hijimasa/reduced-dof-humanoid/docs/design_ja.md

# 軸数削減の検討メモ（ROBO-ONE Light 向け）

Copyright 2026 Masaaki Hijikata. Apache-2.0.

## 1. 動機

Pollen Robotics / Hugging Face の Microduck は 15 軸で歩くが、内訳は脚 5×2（股ヨー・股ロール・股ピッチ・膝・足首ピッチ）、首・頭 4、くちばし 1 で、**腕なし・足首ロールなし**である。約 25 cm、800 g 未満、50 Hz のニューラルポリシーで全軸を駆動する。軸数が少ないのは、足首ロールと腕を捨て、横方向のバランスを制御側で吸収した結果といえる。

従来の小型ヒューマノイド（Microban 19 軸、ROBOTIS OP3 20 軸など）の軸数が歩行に対して過剰かどうかを、ROBO-ONE Light の規則とキーフレーム制御の制約のもとで検討した。

## 2. ROBO-ONE Light 規則で軸数に効く条件

2022 年版競技規則（二足歩行ロボット協会）から抜粋。エントリー前に最新版の確認が必要。

- 重量 1 kg 以下（基板・センサ追加で 1.2 kg まで）。
- 足・二つの脚・二つの腕・胴体・頭を有すること。**二つの腕にはそれぞれ一軸以上の稼働軸**。頭は胴体と別パーツで各辺 2 cm 以上だが、可動要件はない。
- レフリー指示で足裏を 10 mm 以上上げて**前後左右に 3 歩以上**移動できること。
- 歩行中は手先を床から 50 mm 以上離す。しゃがみ歩行（膝 90° 以下）は禁止。
- 足裏は脚長の 55 % 以下（最大 10 cm）、左右幅は脚長の 35 % 以下。脚長は最上部のピッチ軸から足裏まで。
- ダウン後は 10 カウント以内に自力で起き上がる。

## 3. 既存機の軸構成

| 機体 | 総アクチュエータ | 脚/片側 | 腕/片側 | 首・腰 | 備考 |
| --- | --- | --- | --- | --- | --- |
| Microban | 19 | 6 | 3 | 首 1 | 全軸シリアル、約 0.82 kg |
| ROBOTIS Mini | 16 | 5 | 3 | 0 | 股ヨーなし |
| ROBOTIS OP3 / Sigmaban | 20 | 6 | 3 | 首 2 | |
| ashigaru | 14 | 4 | 3 | 0 | 足首ピッチはパラレルリンクで受動、約 0.80 kg |
| Microduck | 15 | 5 | 0 | 首 4 + 口 1 | 足首ロールなし、腕なし |

## 4. 軸ごとの判定

| 軸 | 判定 | 根拠 |
| --- | --- | --- |
| 首・頭 | 削る | 規則は頭の存在と寸法のみ要求。Microduck の首 4 軸はカメラ注視と表情用。 |
| 腰ヨー・脊椎 | 削る | 歩行・起き上がりに不要。 |
| 股ヨー | 削る | ROBOTIS Mini と ashigaru が実証済み。旋回は左右非対称ストライドで代替。規則もハの字歩行を許容。欠点は旋回速度。 |
| 足首ピッチ | 受動化 | 大腿・下腿のパラレルリンクで足裏を骨盤と常に平行に保つ。10 mm 段差の上り下りも足裏が水平のまま行ける。失うのは上体だけの前傾と爪先蹴り。 |
| 足首ロール | 残す | 両足接地で骨盤を横移動させるとき、足首ロールが無いと前額面が剛体トラスになり、荷重移動は足裏のエッジ乗りでしか起きない。Microduck は RL と足裏の大きさで吸収しているが、Light の足裏幅は脚長の 35 % までで余裕が小さい。 |
| 股ロール | 残す | 横移動と片脚支持の必須軸。 |
| 股ピッチ・膝 | 残す | 10 mm の足上げ、しゃがみ歩行禁止、起き上がりの全てに必要。 |
| 肩ピッチ | 残す | 規則最低の一軸。パンチ、伏臥からの腕立て、仰臥での振り起き上がりを兼ねる。 |
| 肩ロール | 削る候補 | 側面攻撃と腕開きを失うが、試合本体の規則上は不要。 |
| 肘ピッチ | 用途次第 | 起き上がりで肘を支点にするなら残す。肩 1 軸だけだと伏臥からの押し上げが腕長固定で苦しい。 |

## 5. 構成案

**案 A（推奨、12 軸）**: 脚は股ロール・股ピッチ・膝・足首ロールの 4 軸でピッチ方向パラレルリンク、腕は肩ピッチ + 肘ピッチの 2 軸、首は固定。キーフレーム制御のまま移行できる。肩ピッチだけの 1 軸腕なら 10 軸だが起き上がりが厳しい。

**案 B（8〜10 軸、動的制御前提）**: 脚は股ロール・股ピッチ・膝の 3 軸、足首ピッチはパラレルリンク受動、足首ロールは剛体またはゴムブッシュの受動コンプライアンス。横の荷重移動は支持脚の股ロールで上体を傾けるアヒル歩き。IMU フィードバックが前提で、両足接地時の荷重移動が足裏エッジ乗りになる点と耐押し性がリスク。

## 6. 第一段階: Microban の足首ピッチ受動化と頭の固定

ashigaru と同じ構造を Microban の MJCF に移植し、首サーボを外した。

- 脚ごとに平行四辺形を 2 つ追加。大腿側は股ブロックと膝ブロックを結ぶ後方リンク、下腿側は膝ブロックと足首ブロックを結ぶ後方リンクで、閉ループは equality の connect で閉じる。
- 膝ブロックは受動関節で常に骨盤と平行。膝サーボはこのブロックと下腿の間に入るので、**膝の指令角は骨盤基準**になる。
- 足首ピッチはアクチュエータを外して受動化。
- 頭はモータ無しで胴体に固定する。頭部パーツは残すのでヒューマノイドらしい外形は保たれ、規則上の「胴体から独立した頭」も満たす。19 軸 → 16 軸。
- 後方ピボットは前方ピボットの 20 mm 後方、大腿側は 5 mm 下、下腿側は 5 mm 上。これで特異点が股屈曲 104°・膝屈曲 104° 側に逃げる。可動域は股ピッチ −96°〜+68°、膝 −68°〜+96°（骨盤基準、正は後方振り）。

検証結果（`tools/verify_parallel_leg.py`）:

| テスト | 結果 |
| --- | --- |
| 閉ループ残差（初期姿勢） | 0.000 mm |
| 股・膝 8 姿勢での足裏と胴体の傾き差（無重力） | 最大 0.4° |
| 床上 3 秒、直立 | 胴体傾き 0.08° |
| 床上 3 秒、股 −30°・膝 +30° | 胴体傾き 0.12°、足裏水平 |
| 床上 3 秒、股 −60°・膝 +60° | 胴体傾き 0.33°、足裏水平 |

注意点:

- 相対膝角 120° 以上の深いしゃがみでは足首ブロックが股ブロックに当たる。元の Microban の部品形状由来。
- （この段階では）後方リンクは見た目専用で、実機のリンクと他部品の干渉は未モデル化。第四段階で衝突形状を付けて見直した。
- 既存の Microban モーションは膝が大腿基準なので作り直しが必要。

## 7. 第二段階: 3D モデル最適化（v2）

起き上がりを阻んでいたのは、相対膝角 117° で足首ブロックの U 字ブラケットが股ブロックのブラケットに当たることと、膝の可動域が +96° で止まることだった。実機の部品設計を先取りして、モデルを次のように変えた。

| 変更 | 内容 | 効果 |
| --- | --- | --- |
| 足首ブロック | 足首ピッチ用 XL330 とアイドラホーンを外し、サーボを囲んでいた U 字ブラケットを受動ヒンジ周りの短いクレビス（衝突形状は軸から ±6 mm）にする | 片足 47 g → 25 g。自己干渉限界 117° → 132° |
| 首 | 胴体上部の首サーボを外し、頭を直付け | 胴体 −23 g |
| 後方リンクの傾き | 5 mm → 10 mm（大腿側は下、下腿側は上） | 特異点が屈曲 104° → 116.6° へ。可動域は股 −109°〜+55°、膝 −55°〜+109°（余裕 8°） |

総質量は 0.833 kg → 0.765 kg。検証スクリプトは全項目合格。

## 8. 第三段階: 12 軸版

`--dof 12` で股ヨーと肩ロールを外した。股ヨーサーボは胴体下部に 2 個あるので胴体から外し、股ブラケットを胴体に直付けする。肩ロールサーボは上腕上端にあるので外し、上腕を肩ブラケットに直付けする（腕は体側に垂れた向きで固定）。質量 0.765 kg → 0.673 kg、アクチュエータ 12。脚は股ロール・股ピッチ・膝・足首ロールの 4 軸で、IK は足裏位置 3 + ロール 1 を 4 関節で解く（向きは成り行き）。旋回は ROBOTIS Mini と同じ両足裏の差動押し出し（scuff turn）で行う。

### 12 軸版の動作検証（LegacyMotionEditor の tools/ による）

歩行キーフレームは胴体座標の足裏目標なので、microban 用に調整済みの歩容を 4 軸脚の IK で解き直すだけで移植できた。旋回は ROBOTIS Mini と同じ scuff turn（両足裏の差動押し出し）。起き上がりは物理ビームサーチ（getup_supine.py）で探索し、時間配分を tune_getup.py で詰めた。sim_check.py の外乱付き試行（サーボ零点誤差 0.3°、初期傾き 1°）での結果:

| 動作 | 成功率 | 備考 |
| --- | --- | --- |
| 前進・後退・横移動 | 8/8 | microban の歩容をそのまま移植して約 33 mm/s。tune_gait.py で 12 軸版向けに再調整すると横移動 71 → 59 フレーム、遊脚 45 → 38 フレームに詰まり約 36 mm/s（8/8） |
| 旋回（scuff turn、左右） | 8/8 | 1 周期あたり約 30° |
| ジャブ（左右） | 8/8 | 肩ロール無し、腰ひねり無し |
| うつ伏せからの起き上がり | 15/16 | 7 姿勢 3.9 s。横転して座り、しゃがんで立つ |
| 仰向けからの起き上がり | 16/16 | 寝返り 1 姿勢 + 上記 |

16 軸版（v2）では同じ起き上がりが 9/16 だった。股ヨーと肩ロールのサーボが無くなって 92 g 軽くなったことで、起き上がり中のサーボ飽和が 98% → 60% に下がり、経路の自由度が減ったのに成功率は上がった。

歩行はいずれも静的歩行で、速度は横方向の重心移動時間で決まる。Microban 本家の RL 歩行（前進指令上限 0.7 m/s）や ROBO-ONE 上位機の歩容は動的歩行で、同じ速度域を狙うなら RL か ZMP ベースの歩容生成が必要になる。

歩行中のトルク（前進歩行の再生）: 脚関節の平均 0.11〜0.18 N·m、上限 0.52 N·m への張り付きは 3〜7%。同じ歩容の microban（上限 0.64 N·m）は平均 0.12〜0.21 N·m、張り付き 2〜5%。同じ速度ならトルクは足りている。

## 9. 第四段階: 14 軸版と採用構成（12 軸標準＋14 軸アップグレード）

12 軸版は両足が常に平行で、旋回が床との滑り（scuff turn）に依存する。足首ロールをピッチのようにパラレルリンクで受動化することはできない（膝が曲がると前額面の脚長が変わり、固定長リンクで閉じない）ので、股ヨーを戻して旋回を床に依らず行う 14 軸を採用した。骨盤を割ってヨー 1 軸で結ぶ 13 軸案もあるが、機構が複雑になるので見送り。構成は脚 5×2（股ヨー・股ロール・股ピッチ・膝・足首ロール）、腕 2×2（肩ピッチ・肘）、頭固定、0.725 kg。`--dof 14`。

入門キットとしての標準は **12 軸**（股ヨー無し。Robovie-nano と同じく旋回はすり足）とし、股ヨーの位置には XL330 と同じ外形の 3D プリント製ダミーブロックを入れておく。あとから本物のサーボに差し替えれば 14 軸になり、股ブラケット以下は共通。外したサーボはすべて同形のダミーに置き換えるので、元のブラケットは無改造で使える。

### 費用概算（本家 BOM の価格、XL330 $23.90、サーボ以外 約 $113）

| 構成 | サーボ | サーボ代 | 合計 | Microban（$567）比 |
| --- | --- | --- | --- | --- |
| Microban | 19 | $454 | $567 | — |
| 12 軸標準 | 12 | $287 | 約 $405 | −$162（−29 %） |
| 14 軸（股ヨー追加） | 14 | $335 | 約 $453 | −$114（−20 %） |

追加部品分（M2 ねじ・ワッシャ・フィラメント）約 $5 を含む。設定用 U2D2（$56）は共通で別。国内代理店価格では XL330 が BOM より高めになる。

下腿側リンクのピボットは、足首ロールサーボ（足首軸の後方）と足を避けるため後方 25 mm・上 25 mm に変更した（docs/parts_ja.md）。膝可動域は −37°〜+127°。

### 最終検証（12 軸標準 / 14 軸）

更新後のモデル（ダミーブロック込み、下腿リンク 25/25、第四段階の前方大腿リンクと衝突形状付きの部品）で、
sim_check の外乱付き 8 試行:

| 動作 | 12 軸標準 | 14 軸 |
| --- | --- | --- |
| 前進・後退・横移動 | 8/8（前進 約 32 mm/s） | 8/8（約 32 mm/s、microban の歩容） |
| 旋回 小/大 | 8/8（scuff、約 33°/周期） | 8/8（股ヨー、72° / 141°） |
| ジャブ左右 | 8/8 | 8/8 |
| うつ伏せからの起き上がり | 8/8（6.7 s、9 姿勢。最終形状で再探索） | 8/8（同じ姿勢列を 14 軸で再タイミング、5.2 s） |
| 仰向けからの起き上がり | 8/8（5.1 s、8 姿勢の直接経路。40 試行で 40/40） | 8/8（同じ姿勢列を 14 軸で再タイミング、4.8 s。39/40） |

設計変更のたびに起き上がりが壊れた経緯は第五段階に書いた。最終形状では前腕を 40 mm 延長したことが効き、
うつ伏せ探索 8 シード中 2 つが膝立ちの局所解に落ちずに立ち上がった（再タイミング前 5/8・6/8）。仰向けからの
直接の経路（腕で上体を起こし、股を −100° まで曲げて座る）も見つかり、大腿リンクを後ろに移して広がった
股の屈曲域が効いている。シード 80 の 8 姿勢は探索時の時間配分で 4/8、`tune_getup.py face_up` で 6.2 s → 5.3 s に
詰めると 12 軸で 8/8（40 試行で 40/40）。それまで使っていた「1 姿勢でうつ伏せに寝返ってから同じ経路」は
7/8（40 試行で 37/40）で 8 s かかっていたので差し替えた。

14 軸は 12 軸のタイミングのままだと仰向けが 3/8 だったが、14 軸モデル自身で再タイミングすると
どちらの起き上がりも 8/8 になった（股ヨーサーボ分 30 g の差はタイミングで吸収できる）。ただし仰向けの再タイミングでは
チューナ自身の 40 試行検証（再生速度の揺らぎ込み）を通る候補が出ず、sim_check の 40 試行では 39/40。
12 軸では 24 候補中 15 が通ったので、14 軸の仰向けは余裕が小さい。

再生速度の揺らぎ（±30%）と転送遅延には依然弱いので、Studio で崩れる場合は `build_project.py --compat` の低速版か、`tune_gait --scale-jitter 0.3` / `tune_getup --scale-jitter 0.3` での再調整を使う。

### 肘の可動域

モデルの肘は本家どおり ±125°（正 = 伸展）で、起き上がりは肘を後ろ側に曲げて押す経路を使う。
人間のように前屈曲のみ（−125°〜+10°、`--elbow-flexion-only`）に制限して探索し直すと、
うつ伏せからの起き上がりは最良でも 5/16 にとどまった（制限なしは再タイミング後 15/16）。
前腕は上腕とどちら向きでも干渉しないので、既定は本家の範囲のままにしている。

### LegacyMotionEditor / MuJoCo Studio で詰まった点

- Studio は物理の刻みを 10 ms に固定していた。閉ループ拘束（solref 5 ms）には粗すぎるので、
  モデルの刻み（2 ms）を使い 10 ms を上限とするように変更した。
- 受動関節に `r_knee_yp_1` という名前を付けていたが、これは LME の Meridim 対応表で膝サーボと同じ
  スロットの別名だった。LME が受動関節の角度も送っていたため膝の目標値が 100 Hz で 2 値を行き来し、
  静止中でも脚が痙攣した。受動関節名を対応表に無いもの（`r_kneeblock_yp` など）に変え、LME 側でも
  受動関節を送らないようにした。**受動関節には Meridim 対応表にある名前を付けないこと。**
- 大腿・脛のボディ原点は脚の中心面ではなく内側の側板上にある。横方向の配置は膝サーボの中心を基準にする。

### ROBO-ONE Light 規定の照合

- 脚長（股ピッチ軸〜足裏、脚を伸ばした状態）は 146.2 mm。足裏の上限は前後 80.4 mm、左右 51.2 mm。
- Microban の足裏は 90 × 45 mm で、**前後が 9.6 mm 超過**。接地板を 80 mm にした（`--sole-length 0.080` を既定に）。
  実機の足部品も先端と踵を 5 mm ずつ詰める必要がある。立位での左右の足裏の間隔は 27 mm で重ならない。
- しゃがみ歩行の判定（膝関節 90° 以下）に対し、microban 由来の歩容は立位で膝内角 105.7° だが、遊脚を上げる
  キーフレームでちょうど 90.0°（14 軸の大旋回では 86°）に達していた。足裏 80 mm では旧歩容の前進が 0/8 になる
  こともあり、Z0 ≤ −0.141（立位で膝内角 117° 以上、遊脚で 102° 以上）に探索範囲を絞って歩容を再調整した。

### 第四段階: リンク部品の干渉チェックと配置の見直し

「リンクの部品が干渉しているように見える」との指摘を受け、追加部品に凸包の衝突形状を持たせて
股・膝の可動域全体を走査した（`tools/check_clearance.py`）。見た目専用だった旧配置（大腿バーを
大腿の後ろに内外 2 本）には本物の干渉があった。

| 干渉 | 対処 |
| --- | --- |
| 左右脚の内側の大腿バー同士が 8 mm しか離れておらず、股ロールで当たる | 内側バーを廃止、脚ごとに外側 1 本ずつ |
| 大腿バーと下腿バーが同じ面にあり、股屈曲 60° 以上で交差 | 大腿リンクを大腿の**前方**（当初 前 22 mm・上 10 mm、第五段階で前 27・上 12）に移し、バーの面を分離（最終的に 22.5〜25.5 / 26〜29 mm） |
| 後方の大腿バーが垂らした前腕に当たる | 前方化で解消 |
| 前方の大腿バーが股屈曲 90° 以上で膝軸キャップのスタブに当たる | 股屈曲の可動域を 85° で打ち切り（起き上がりで使うのは 37° まで）。ピボットを 16 mm 上げる案は伸展側の特異点が 54° になり、起き上がりの股伸展 55° が入らないので不採用 |
| 歩行で股を 45° 曲げると膝ヨーク板の上端が前腕に 2 mm 食い込む（サーボ飽和率 19 % → 72 %） | ヨーク板の縁を 7 → 5 mm に詰める |
| 肘を前に曲げると前腕が大腿バーとヨーク前端に当たる（前 40° で 3.5 mm、前 60° で 0.6 mm。後ろ曲げなら当たらない） | 肩ロールのダミーブロックのホーンを 30° 割り出し、腕を 30° 外転（`--arm-abduct 30`）。歩行の姿勢範囲で肘 0〜−90° のどれでも干渉なし。歩容の基本姿勢は人間のように肘前 60° |
| キャップ（フランジ＋スタブ）の凸包が円錐になり偽の干渉を報告 | キャップの衝突形状だけ円柱 2 本に分割 |

結果、可動域内の干渉はゼロ。可動域は股ピッチ −85°〜+58°、膝 −37°〜+127°。歩容はすべて 8/8 のまま。
一方、うつ伏せでは大腿の前に出たバーとヨークが床に先に着くため、以前の起き上がり経路は通らなくなり、
衝突形状付きのモデルで起き上がりを探索し直した（結果は上の最終検証の表）。

腕を 30° 外転させると、部品の衝突形状付きで見つけた 5 姿勢の起き上がりも通らなくなった（腕の形が変わると
押す位置が変わる）。探索し直すと 16 シード中 15 が「膝立ちで止まる」局所解（胴体ピッチ 20°、重心高 89 mm）に
落ちた。パラレルリンク脚は骨盤を立てたまま膝立ちすると足裏が垂直になるので、そこから立つ経路は骨盤を大きく
前傾させるものしかなく、股屈曲の上限 85° が原因かと疑って上限 100° の試験モデルでも探索したが、見つかった
経路（s32）は股屈曲 −20°〜伸展 58° しか使っておらず、上限 85° のモデルでもそのまま同じ結果（再タイミング前
4/8）だった。つまり上限は原因ではなく、探索のばらつき。見つかった経路は寝返って反対向きに立つ 6 姿勢。

教訓: **リンク機構は見た目だけでなく衝突形状を付けて可動域を走査してから設計を固めること。** 凸包の
衝突形状は段付きの部品で偽陽性を出すので、形状を分けるか原始形状で置き換える。

### 第五段階: ダミーサーボの一体設計化

足首ピッチ・肩ロール・首の XL330 形状ダミーを、隣の印刷部品と一体の部品に置き換えた（`tools/make_parts.py` が
Microban の STEP から生成、`model/parts_derived/`）。

| 部位 | 置き換え | 要点 |
| --- | --- | --- |
| 足首 | ankle_dbl_block ＋ ダミー → ankle_block_integrated | キャップにヒンジ体を融合。Ø5.9 スタブ軸が脛側板の既存穴に入り、下腿バーのピボットボスも一体（スタンドオフ不要） |
| 肩ロール | shoulder（U 字ブラケット）＋ humerus ＋ ダミー → shoulder_arm_simple | ホーン板・梁・柱・肘板だけの単純な 1 部品（穴位置と肘サーボの角ポケットだけ継承）。腕は元のロール軸まわりに ±30° 回した形で固める。肩ピッチホーンのねじにはドライバを通す Ø5 の段付き穴 |
| 首 | head ＋ ダミー → head_integrated | 頭の裏の旧ホーン座を埋め、旧サーボ軸上の素直なステムで台座につないだ 1 部品。逆さ付けの首サーボのポケットに入り、胴体の内側から M2 4 本で固定。頭の高さは変えない |

股ヨーのダミーだけは 14 軸への差し替えのために XL330 形状のまま（2 mm シェルに変更）。質量は印刷部品を
1.0 g/cm³ で計上して 12 軸 0.735 → 0.726 kg、14 軸 0.765 → 0.756 kg（公開前の最終確認で肩＋上腕の体積が
旧形状の 9.5 cm³ のままだったのを CAD 値 13.5 cm³ に直し、12 軸 0.734 kg・14 軸 0.764 kg）。
あわせて、大腿バーの上側ピボットを受ける股の耳（hip_front_ear）が生成はされていたのにモデルに置かれておらず、
LME の表示でバーの上端が浮いて見えていた。置いてみると大腿側板と丸ごと干渉していたので（側壁に貼る板が側板の
位置そのものだった）、別部品をやめて股ブラケットから生やす支持にした。大腿側板は股軸の前方を扇状に掃き、
前縁は軸から 40 mm 以上離れているので、軸の前では側板の面（|x| 14.5〜18.5）を横切れない。支持は軸の後ろ下で
ブラケットを出て側板をくぐり、側板の外を前へ回ってピボットに至る。ピボットは軸から 29.5 mm（前 27・上 12）に
移し、バーの面を 1.5 mm 外へずらした。CAD で大腿（股ピッチ全域）と骨盤側ブラケット（ロール ±35°）に対して
交差ゼロを確認。さらに「もっとリンクの支持点の近くから」との指摘で、腕を外転させた今は前腕を避ける理由が
無いことから大腿リンクを後ろ（後方 22・下 8）に戻した。股側ピボットは股ブラケットの後ろ裾のすぐ横に来るので
支持は 23 mm のラグで済み、可動域も股 −100°〜+62° に広がった。両バーが後ろにあるため大腿バーはヨークの外側
（35〜38 mm）に出す（内側だとヨークの下腿ピンが掃き、股伸展 57° 以上で膝軸スタブに触れる）。膝のピン穴を
共通化する案は、股の伸展範囲と膝の屈曲範囲の要求が逆向きで採れなかった。
肩の一体部品も、細い板と梁の組合せは印刷に向かず鋭角も多いという指摘で、壁 3 mm の太い胴と柱に作り直した。
腕は KXR や Robovie-nano より短く見えるとの指摘で、前腕を 40 mm 延長した（肩軸から 183 mm。規定は 26 cm まで、
歩行中の手先高さ 50 mm 以上に対して腕を伸ばした屈み姿勢でも 86 mm）。肘サーボの保持も最初は端面にねじ穴がある前提で間違えていたので、Microban の上腕プレートと同じく
ホーン側・アイドラ側の面の上隅穴にホーン軸方向のねじで留める 2 枚のタブに直した（穴軸と面位置をモデル上で照合）。`--dummies` で旧構成を生成できる。
Robovie-nano のようなすね 1 段のリンクは、足裏が大腿と平行になり歩幅を持つ両脚支持で足裏を平らにできないので
採用しない（足裏を骨盤と平行に保つには関節ごとに 1 段、計 2 段が要る）。

## 10. 次の段階

1. ドラフト部品を Onshape で元部品と組み合わせてフィット確認し、印刷する（未確認事項は parts_ja.md）。
2. 脚長が確定したら足裏寸法を ROBO-ONE Light の表（55 % / 35 %）と照合する。
3. 動的歩行を試すなら、本家の学習パイプライン mjlab_microban にこのモデルを差し替える。

## 参考

- Pollen Robotics, Microduck press kit: https://pollen-robotics.com/microduck/press-kit/
- CNX Software, Microduck 記事 (2026-08-28): https://www.cnx-software.com/2026/08/28/microduck-a-duck-like-biped-robot-designed-for-physical-ai-experimentation-and-fun/
- OpenELAB, MicroDuck build guide（関節 ID 表）: https://openelab.io/fi/blogs/robotics/microduck-build-guide-openelab
- 二足歩行ロボット協会, ROBO-ONE/Light/auto 競技規則 (2022): https://www.robo-one.com/upload/roboones/65_63bfd2f1042650ddc6d9e47ad179db2eoriginal.pdf
- Rhoban, Microban: https://github.com/Rhoban/microban
