hijimasa/reduced-dof-humanoid/docs/images/preview.png

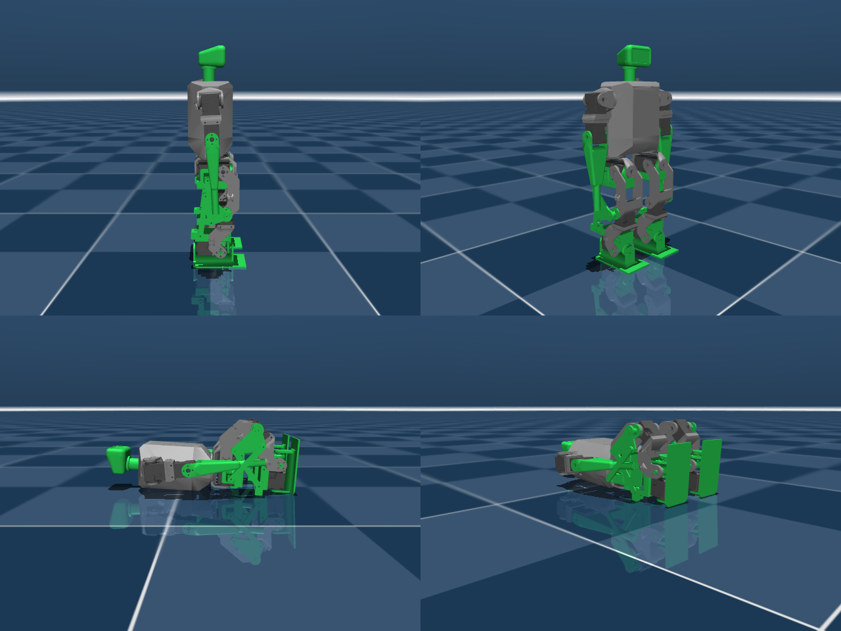
docs/images/preview.png
