hijimasa/reduced-dof-humanoid/docs/parts_ja.md

# パラレルリンク化で追加・変更する部品（設計メモ）

Copyright 2026 Masaaki Hijikata. Apache-2.0.

`tools/make_parts.py`（CadQuery）が `model/parts/` に出力する STL は**フィット確認前のドラフト**です。
寸法は MJCF の関節配置と、Microban の STEP ファイルから読み取った穴パターンに基づきますが、
まだ一度も印刷していません。Onshape で元部品と組み合わせて確認してから使ってください。

モデル上ではこれらの部品（緑）に凸包の衝突形状を持たせてあり、`tools/check_clearance.py` が
股ピッチ・膝の可動域全体を走査して他部品との干渉を報告します。現在の配置では可動域内に干渉はありません
（腕を真下に垂らしたまましゃがむと前腕が下腿バーに 0.5 mm 触れる姿勢だけが残っています。どのモーションも
そこへは行きません）。

## 座標系

Microban の Onshape 部品（femur_right.step、tibia_right.step、ankle_dbl_block.step）は同じ
「脚座標系」で出力されています。右脚で x = 外側、y = 前、z = 上、単位 mm。
股ピッチ軸 (y 3.0, z 132.7)、膝軸 (8.0, 70.7)、足首軸 (0.0, 9.5) は STEP の穴中心と一致します。
側板は |x| 14.5〜18.5、サーボ本体は |x| ≤ 10、股・足首ブラケットの側壁は |x| 11.5〜13.5。

注意: MJCF の大腿・脛ボディの原点は脚の中心面ではなく**内側の側板上**（中心から 14.5 mm 内側）にあります。
横方向の配置はすべて膝サーボの中心（ホーン面とアイドラ面の中点）を脚の中心面として測ります。
生成器はこれを `c_z`（ボディ座標）と `x_c`（STEP 座標）として計算しています。
また、クレビスはサーボに対して非対称で、ホーン側は側板内面までサーボ面から 4.5 mm（ホーン 3 + 1.5）、
アイドラ側は側板がサーボ面に接しています。足首ヒンジ用ダミーのスペーサ長はそれに合わせています。

## ピボット配置（`make_microban_pl.py` の既定値）

| リンク | 上側ピボット | 下側ピボット | リンク長 | 特異点 |
| --- | --- | --- | --- | --- |
| 大腿（**後方** 22、下 8） | 股ブラケットのラグ (y −19.0, z 124.7) | 膝ヨーク (−14.0, 62.7) | 62.2 | 屈曲 110.6°、伸展 69.4° |
| 下腿（後方 30、上 30） | 膝ヨーク (−22.0, 100.7) | 足首ブロックのボス (−30.0, 39.5) | 61.7 | 屈曲 135°、伸展 45° |

可動域は特異点から 8° の余裕をとり、股ピッチ −100°〜+62°、膝 −37°〜+127°（骨盤基準、正は後方振り）。
起き上がりで使うのは股 −37°〜+55°、歩行は −45°〜0° です。

## 横方向の積層（脚の中心面からの距離、右脚）

| 面 | x [mm] | 部品 |
| --- | --- | --- |
| 大腿・脛の側板 | 14.5〜18.5 | 元部品 |
| 膝軸キャップのフランジ | 18.5〜20.5 | knee_axle_cap（膝サーボのホーンねじで共締め） |
| 下腿バー | 26〜29 | shank_bar（ヨークに隣接、スペーサ無し） |
| 膝ヨーク板 | 29.5〜32.5 | knee_yoke（キャップの Ø8 スタブに乗る。スタブは 33 まで、皿 M2 で抜け止め） |
| 大腿バー | 35〜38 | thigh_bar（ヨークの外側。ヨークから Ø6 スペーサ 2 mm で受ける） |
| 股ブラケットのラグ | 11〜34.5 | hip_block_integrated（10×10 の角柱、先端に Ø2.2 のピン穴） |

3 本の面は 0.5 mm ずつ離してあり、バー同士は面が違うので股を深く曲げてもすれ違えます。
垂らした前腕は x 22〜32.5、z 112 以上を占めるので、この積層は丸ごと前腕の下に入ります。

## 配置の経緯（干渉チェックで直した点）

最初の案は大腿リンクを大腿の後方に置き、各脚に内側・外側 2 本のバーを通していました。衝突形状を付けて
調べると次の干渉があり、現在の配置に改めました。

- 左右脚の内側バー同士の間隔が 8 mm しかなく、股ロールで脚を寄せると当たる。→ 内側バーを廃止し、
  バーは外側 1 本ずつに。
- 後方の大腿バーと下腿バーが同じ面にあり、股屈曲 60° 以上で交差する。→ 大腿リンクを大腿の**前方**に
  移し、バーの面も分けた。
- 後方の大腿バーが垂らした前腕に当たる。→ 前方化で解消。
- 大腿バーを前方にすると、股屈曲 90° 以上で大腿バーが膝軸の上を通り、膝軸キャップの Ø8 スタブに
  当たる（ピボットを 16 mm 上げれば 100° まで逃げるが、伸展側の特異点が 54° に下がり、起き上がりで
  使う股伸展 55° が入らなくなる）。→ ピボットは上 10 mm のまま、股の屈曲側の可動域を 85° で打ち切った
  （85° で余裕 2 mm）。
- 歩行で股を 45° 曲げたとき、膝ヨーク板の上端が垂らした前腕に 2 mm 食い込む。→ ヨーク板の縁の
  オフセットを 7 → 5 mm にして上端を下げた。
- 垂らした前腕（脚中心から 22〜32 mm）はリンク積層（21〜31 mm）の真上にあり、肘を前に曲げると前腕が
  大腿バーとヨーク前端に当たる（前 40° で 3.5 mm、前 60° で 0.6 mm）。後ろ曲げなら当たらないが
  人間らしくない。→ 肩ロールのダミーブロックのホーンを 30° 割り出して腕を外転させた。肘は 24 mm
  外に出て、歩行の姿勢範囲（股 0〜−55°、膝 20〜70°、肩 −15〜40°、股ロール ±10°）で肘 0〜−90° の
  どれでも前腕は部品に触れない。歩容の基本姿勢は肘前 60°。
- MuJoCo はメッシュを凸包で扱うので、フランジ＋スタブのキャップを 1 つのメッシュにすると円錐状の
  偽の干渉が出る。キャップの衝突形状だけは円柱 2 本にしてある。

## 配置の制約（部品の占有範囲を脚座標系に写して確認）

- 股ロールサーボ（x ±10、y −35.5〜−9.5、z 108〜142）が股ピッチ軸の後方にある。大腿側板（|x| 14.5〜18.5）は
  股軸の前方を扇状に掃く（前縁は軸から 40 mm 以上）ので、軸の前では x 14.5〜18.5 を横切れない。前のバーの
  ときは支持が軸の後ろ下から側板をくぐり外側を前へ回る長い迂回になった。大腿リンクを後ろ（後方 22・下 8）に
  すると、股側ピボット (−19, 124.7) は股ブラケットの後ろ裾（x 11.5〜13.5、y −30〜−6、z 117〜125）のすぐ横、
  大腿が伸展の限界でもかすめない象限に来るので、裾から x 34.5 まで伸びる 10×10 のラグだけで持てる。
  CAD で大腿（股ピッチ −62°〜+100°）と骨盤側ブラケット（ロール ±35°）に対して交差体積ゼロを確認。
- 両バーを後ろに置くと、ヨーク上の 2 つのピンが互いのバーの掃引域に入りやすい。大腿バーをヨークの内側に
  置くと、ヨークの下腿ピン用スペーサが大腿バーの面を横切り、膝屈曲でそこを下腿バーが掃く。さらに後ろ・下の
  大腿バーは股伸展 57° 以上で膝軸の Ø8 スタブに触れる。そこで大腿バーをヨークの外側（35〜38）に出した。
  スタブは 33 までで皿 M2 で抜け止めし、バーとの隙間は 2 mm。膝のピン穴を共通化する案（大腿・下腿の
  オフセットを同じにする）は、股の伸展範囲（下オフセットを小さく）と膝の屈曲範囲（上オフセットを大きく）の
  要求が逆向きで、どちらかを起き上がりの必要量より削ることになるので採らなかった。
- 足首ロールサーボ（x ±10、y −38.5〜−12.5、z 0〜34）が足首軸の後方にある。下腿リンクの下側ピボットを
  後方 20・上 10 にすると中に入るので、後方 25・上 25 に上げた。
- 脛（側板は y −18 まで）: 下腿リンクは z < 51 で y < −18 に収まる必要があり、後方 25 で満たす。
- 足（x ±22.5、z ≤ 18.5）: 下腿リンク下端（z 34.5）は足の上面より上。
- うつ伏せに寝ると、大腿の前面より 12 mm ほど出ている大腿バーとヨークが床に先に着く。起き上がりの
  探索はこの状態から行っている。実機では M2 ピンと 3 mm 厚 PLA のバーに体重の一部が掛かるので、
  印刷後に確認すること。

## 部品一覧

| 部品 | 数 | 内容 | 取り付け |
| --- | --- | --- | --- |
| thigh_bar | 2 | 3×8 mm、ピン間 62.2 mm、Ø2.2 | 脚ごとに後方・ヨークの外側 1 本、x = 35〜38 |
| shank_bar | 2 | 3×8 mm、ピン間 61.7 mm | 脚ごとに後方・ヨークの内側 1 本、x = 26〜29 |
| knee_yoke_right / left | 各 1 | 膝軸・大腿ピボット・下腿ピボットの三角板（縁 5 mm、膝軸まわり Ø16）。膝軸は Ø8.2 の穴、各ピボットは M2 ピンとバーまでの Ø6 スペーサ一体 | x = 29.5〜32.5、膝軸キャップのスタブに乗せ M2 で抜け止め |
| knee_axle_cap | 2 | Ø18×2 のフランジ（PCD 12 の M2×4 で膝サーボのホーンに共締め、大腿側板を貫通するので M2×12 に延長）＋ Ø8×12.5 のスタブ（x 33 まで、ヨーク板から 0.5 mm 出る）、先端に皿 M2 用タップ | 大腿側板外面（x 18.5）から外へ |
| standoff_shank_ankle | 2 | 12.5 mm スペーサ（`--dummies` 版のみ） | 足首ブラケット側壁（13.5）→ 下腿バー（26）。一体化版では足首ブロックの支持に置き換わる |
| ankle_block_integrated_right / left（parts_derived） | 各 1 | Microban の足首ブロック（2 つのサーボの上に被さるキャップ）に、足首ピッチサーボの代わりのヒンジ体を融合した 1 部品。ピッチ軸上に Ø12 ボス（x −11.5〜14）、両端に Ø5.9 スタブ（ホーン側は Ø12 カラー 2.7 mm 付きで x −20 まで、アイドラ側は x 20 まで）、先端に M2 タップ。ボスから上は 1.6 mm 壁の中空柱でキャップに連結。下腿バーのピボット支持も一体: キャップ後端の角に根元ブロック（x 11〜14、y −38.5〜−30、z 31〜44、側板の内側）、そこから出る 8×8 の梁（y −44〜−38、z 36〜44。足首軸から r ≥ 46 mm で、脛側板が膝伸展で掃く帯 r ≤ 45・113〜150° の外）、側板の外（x 21〜25.5）で前へ戻る腕（y −44〜−25、z 33〜44）にピン穴 (−30, 39.5)。以前の Ø6 片持ちボスは廃止。CAD で脛（膝 −37°〜+127°）・足（ロール ±35°）と交差ゼロ | キャップの元の位置。ロールサーボには元どおりねじ止め |
| shoulder_arm_simple_right / left | 各 1 | 肩ブラケット＋上腕の太い一体部品（Microban の形状は使わず、インターフェースだけ継承）。上腕座標で: 肩ピッチホーンの板 x −52.2〜−48.2（4 mm、y ±11、z 12〜37、面取り）に PCD 12 の M2 穴 4 本（(y ±6, z 24.5)・(0, 18.5)・(0, 30.5)）と Ø7.5 の中心穴。肘サーボは Microban の上腕プレートと同じ持ち方: XL330 の端面にねじ穴は無いので、天板（z −2.5〜1.5、x −47.5〜−17.5、y ±11.5、面取り）から下がる 2 枚の短いタブ（x −46.6〜−44.2 と −20.6〜−18.2、z −8〜−2.5）に、ホーン軸方向（x）の Ø2.2 穴を (y ±8, z −4.5) に開け、サーボのホーン側の面とアイドラ側の面の上隅の穴に M2 を通す（穴面は Microban と同じ x −45.4 / −20.0）。左腕の部品は右腕の部品をロール軸の面（上腕座標 x = −32.7）で鏡像にしたもの。Microban の左腕は右腕をこの面で鏡像にした配置（肩ピッチホーンが x −13.2、肘サーボのホーンが反対端）なので、これで肩ピッチ板・肘タブとも左右で正しい側に来る（モデル上で数値確認済み）。16×16 の中空柱（壁 3 mm）を肘板から立て、肘板＋柱を元のロール軸 (x −32.7, z 24.5) まわりに右 −30°・左 +30° 回してから、24×18×21 の胴（壁 3 mm、x −48.2〜−24）でホーン板につなぐ。ホーンのねじは外側から締めるので、胴と柱を貫く Ø5 の段付き穴を通してドライバを入れる。オーバーハング無し。モデル上でタブの穴軸がホーン軸と平行で、タブ面がサーボのホーン面の 1.2 mm 外にあることを数値で確認済み | 肩ピッチサーボのホーンに M2 4 本。肘サーボはホーン側・アイドラ側の面に 2 本ずつ |
| head_integrated（parts_derived） | 1 | Microban の頭（head.step）に首を生やした 1 部品。頭の裏の旧ホーン座（PCD 12 の穴、座ぐり）は Ø24 のパッドで埋め、旧サーボ軸上の Ø18/Ø12 中空ステムが、胴体上面のポケット（20×34、深さ 7.5）に入る中空の台座（床 2 mm、壁 1.6 mm）まで下りる。底面にホーンの PCD 12 に合わせた M2 タップ 4 本 | 胴体上部のポケット。Microban は首サーボを逆さに付けており（ホーンが胴体側、頭がサーボ本体側）、胴体の内側からポケットの床越しに 4 本の M2 で固定する（胴体上カバーを外して作業） |
| hip_block_integrated_right / left（parts_derived） | 各 1 | Microban の股ブラケット（hip_dbl_block）に大腿バーの上側ピボットのラグを生やした 1 部品。裾の外面に 22×24 のフランジ（x 11〜14、角 R3）を当てて薄い壁に荷重を広げ、そこから 20×22 → 12×12（2 mm で絞る）→ 10×10（x 34.5）とテーパーするラグ、付け根は R2.5 のフィレット（直角の根元にしない）。先端に Ø2.2 のピン穴 (−19.0, 124.7) | 元の股ブラケットの位置。ねじは増えない |
| radius_long（parts_derived） | 2 | Microban の前腕（radius.step）の手先に、前腕軸に沿って Ø10・長さ 40 mm の棒（先端 R5）を生やしたもの。腕は肩軸から 183 mm。モデルでは衝突形状として同じ位置にカプセルを置く | 元の前腕の位置 |
| xl330_dummy_hip_yaw | 2 | XL330 の外形（20×34×26、2 mm シェル）と背面 4 穴、固定ホーン付き。12 軸標準構成で股ヨーサーボの位置に入れ、14 軸化のときに本物と差し替える | 胴体下部、股ブラケットの上 |
| xl330_dummy_shoulder_roll_right / left、xl330_dummy_neck、xl330_dummy_ankle_hinge | 代替 | 一体化部品を使わない場合（`--dummies`）の XL330 形状ダミー。肩ロール用はホーン穴を ±30° 割り出し、足首用は両面に Ø5.9 スタブ軸 | それぞれのサーボの位置 |

既存部品の変更:

- hip_dbl_block: 一体化部品 hip_block_integrated に置き換える（元の形状を含む）。
- ankle_dbl_block: 一体化部品 ankle_block_integrated に置き換える（元のキャップ形状を含む）。`--dummies` 版では元のまま使い、xl330_dummy_ankle_hinge を入れて側壁 (y −25.0, z 34.5) に M2 穴を追加。
- shoulder（U 字ブラケット）と humerus: 新設計の shoulder_arm_simple に置き換える（元形状は使わない）。
- head: 一体化部品 head_integrated に置き換える（元の頭の形状を含む）。trunk_top は変更なしで、首サーボのポケットと穴をそのまま使う。
- 足首ピッチの受動ヒンジは、脛側板の既存の Ø6 穴（ホーン側・アイドラ側）をそのまま軸受けに使う想定。
- 足: 接地板を先端側で 10 mm 詰めて 80 mm にする（ROBO-ONE Light の 55 % 規定、`model/parts_derived/foot_sole80`）。

## ダミーの一体化（足首・肩・首）

XL330 形状のダミーは「元の部品を無改変で使う」ための暫定品で、隣の印刷部品と 1 つにできる。
インターフェースの寸法は Microban の robot.xml（サーボの位置と向き）と STEP ファイルから読み取った。

- 足首: 足首ピッチサーボは x −11.5〜14.5、y ±10、z 0〜34 に立っていて、ホーンが x −11.5 側（ホーン円板 −11.5〜−14.5 が
  脛側板の内面 14.5 に接する）、アイドルキャップが x 14.5 側。キャップ（ankle_dbl_block）は両サーボの上面に乗る。
  サーボを抜いた穴にヒンジ体（Ø12 ボス＋中空柱）を融合し、キャップは元の形のまま残すのでロールサーボ側の
  取り付けは変わらない。ブロックは左右で同じ向きに付いているので、ホーン側（−x）は右脚では内側、左脚では外側になる。
  外側に出す下腿バーのピボットボスだけ左右で側を変える（右 +x、左 −x）。
- 肩: 肩ロールサーボは上腕プレートの上に立ち、ホーン軸は前後方向（+y）。元のブラケットは上腕座標で x −52.2〜−23.7 を
  占め、基板（x −52.2〜−48.4）が肩ピッチホーンに付く（PCD 12、robot.xml と shoulder.step から）。最初は元の U 字
  ブラケットと上腕プレートをそのまま融合したが、印刷するには複雑すぎるので、ホーン板・梁・柱・肘板だけの単純な
  形に設計し直した（ホーンの穴位置と肘サーボの穴位置・角ポケットだけを継承）。ホーンのねじは板の外側から締める
  ので、梁と柱を貫く Ø5 の穴をねじ軸に沿って開け、ドライバを通す。
- 首: Microban は首サーボを逆さに付けていて、ホーン（z 148.4、PCD 12）が胴体上面のポケットの床に、頭（z 174.4）が
  サーボ本体の上端に付く。頭の STEP 座標は胴体上面の STEP 座標と同じ。頭の裏の旧ホーン座は埋めて、旧サーボ軸
  (36, 7.79) 上の素直なステムで台座につないだ。固定は胴体の内側からポケットの床越しに M2 4 本。
- 質量（1.0 g/cm³ 換算、make_parts.py が出力する CAD 体積）: 足首ブロック 9.2 → 17.3 cm³、股ブラケット 9.7 → 13.3 cm³、
  肩ブラケット 8.8 ＋ 上腕 4.3 → 肩＋上腕 13.5 cm³、頭に生やした首 6.4 cm³、前腕の延長 +2.8 cm³（モデルでは 4 g で計上）。
  XL330 形状ダミーは 2 mm シェルで 7.7 cm³。モデルの総質量は 12 軸 0.734 kg、14 軸 0.764 kg、16 軸 0.809 kg。
- 一体化部品には衝突形状を付けていない（元の部品にも無い）。足首の衝突は従来どおり短いクレビスの箱で表す。

## 未確認事項

- XL330 背面穴パターン（16 × 25.5 mm）は STEP の穴座標からの推定。実物で確認すること。胴体上面のポケットには
  (28, −14.7)・(44, 15.3) の対角 2 穴（Ø2.5）があり 16 × 30 のパターンに見える。head_integrated の台座の底はホーンの PCD 12 だけに
  合わせてある。
- 一体化部品は印刷していない。ヒンジ体（1.6 mm 壁の中空柱）と上腕の柱の剛性、ankle のキャップ部の元形状との
  融合面（z 31〜34）が意図どおり繋がっているかを CAD で確認すること。肩の Ø5 アクセス穴は M2 のドライバ軸
  （Ø3〜4）を想定しているので、使うドライバに合わせて径を直すこと。
- 首ポスト付きの頭は胴体の内側から固定するため、胴体上カバー（trunk_top）を外した状態で組む手順になる。
- 足首側のピボット支持は、脛側板の掃引帯を避けるために軸から遠回りする 8×8 の梁（長さ 15 mm）と腕（12 mm）。
  下腿バーの引張り上限は膝サーボのストールトルク / てこ 42 mm ≈ 12 N で、梁の曲げは 0.2 N·m 程度（PLA で 4 MPa）。
  キャップ（2.5 mm 厚）側の根元は 8.5×13 mm の面で融合するが、キャップ自体が薄いので当て板を検討。
- 膝ヨークが片持ちで足りる剛性か（PLA、荷重はリンク反力のみ）。Ø8 の PLA スタブで不足なら、
  キャップ中心に M3 を通してボルトを軸にする。
- 股ブラケットのラグは 23 mm の片持ち。大腿バーの力はバーの軸方向（ほぼ鉛直）で、膝サーボのストールトルク
  0.52 N·m をてこ 23.4 mm で割った約 22 N が上限。根元の曲げは約 0.5 N·m で、20×22 の根元断面なら 1 MPa 以下
  （PLA）。根元はフランジとフィレットで直角を避けたが、積層方向（裾の面に平行に印刷すると層間がラグの曲げを
  受ける）には注意。横向き（ラグを寝かせて）印刷するか、裾の内側に当て板を入れることを印刷時に検討。
- うつ伏せ時に大腿バーとヨークが床に着くこと（上記）。
- 肘を前に 60° 曲げた歩行の基本姿勢で手先は床から約 110 mm（規定 50 mm 以上）。実機の腕と脚の
  間隔は前腕の径（Ø10.4 でモデル化）と外転角に依存する。外転 30° は余裕が大きい（前腕内側とヨーク
  外面で約 35 mm）ので、見た目を優先するなら 15〜20° まで減らせる。
