hijimasa/reduced-dof-humanoid/model/microban_pl/assets/radius.stl

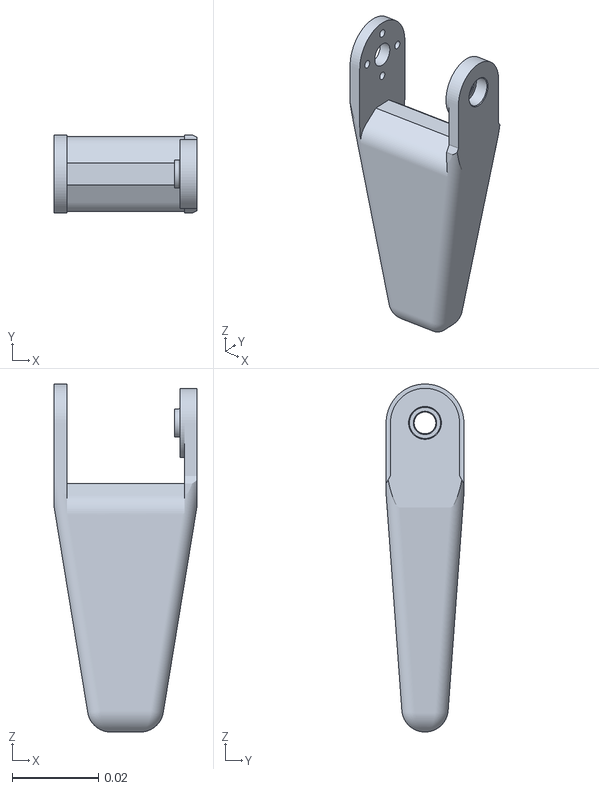
[picture p6: CAD file, 2026-10-16]
model/microban_pl/assets/radius.stl
0.033 x 0.018 x 0.0805
