hijimasa/reduced-dof-humanoid/model/parts/shoulder_arm_simple_left.step

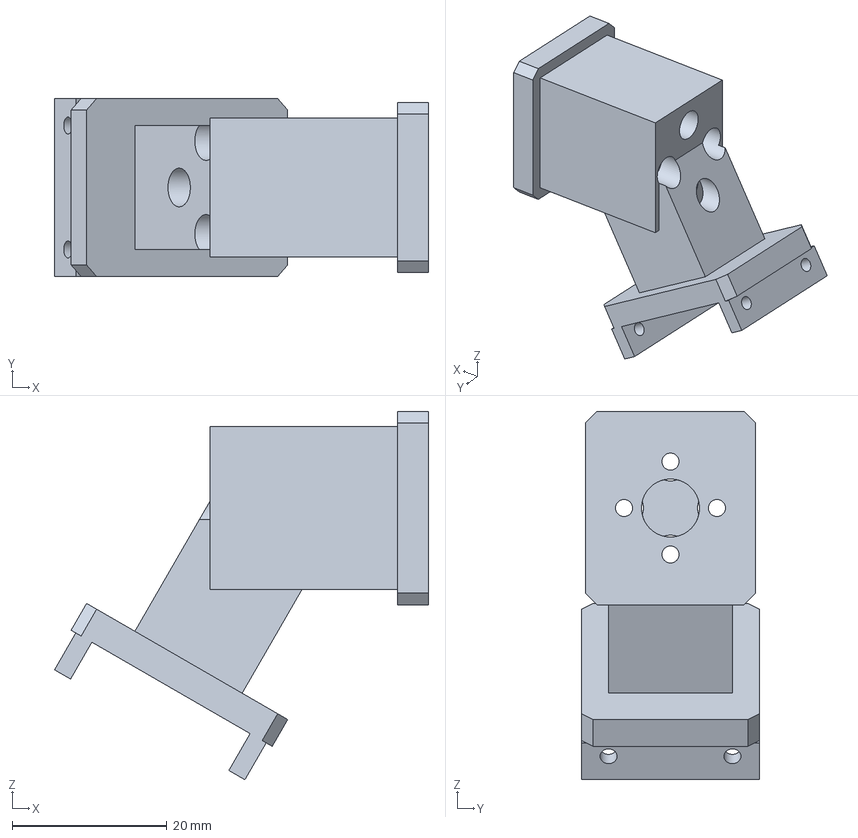
[picture p7: CAD file, 2026-10-17]
model/parts/shoulder_arm_simple_left.step
48.3 x 23.0 x 47.6 mm
