hijimasa/reduced-dof-humanoid/model/parts_derived/ankle_block_integrated_right.step

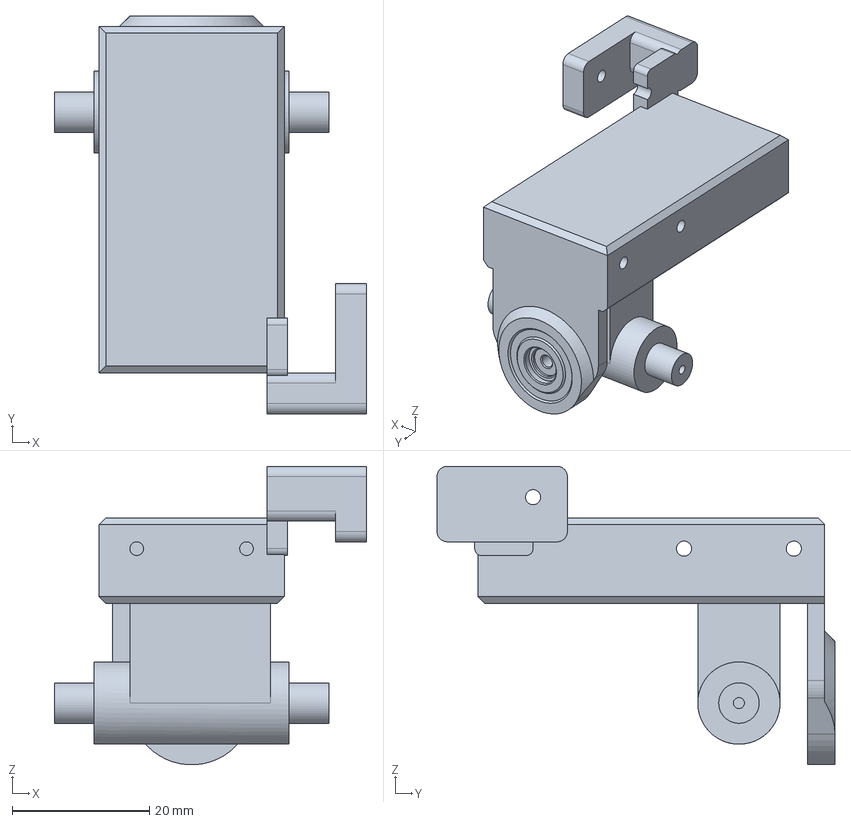
[picture p8: CAD file, 2026-10-17]
model/parts_derived/ankle_block_integrated_right.step
45.5 x 58.0 x 43.5 mm
