hijimasa/reduced-dof-humanoid/model/microban_pl/assets/switch.stl

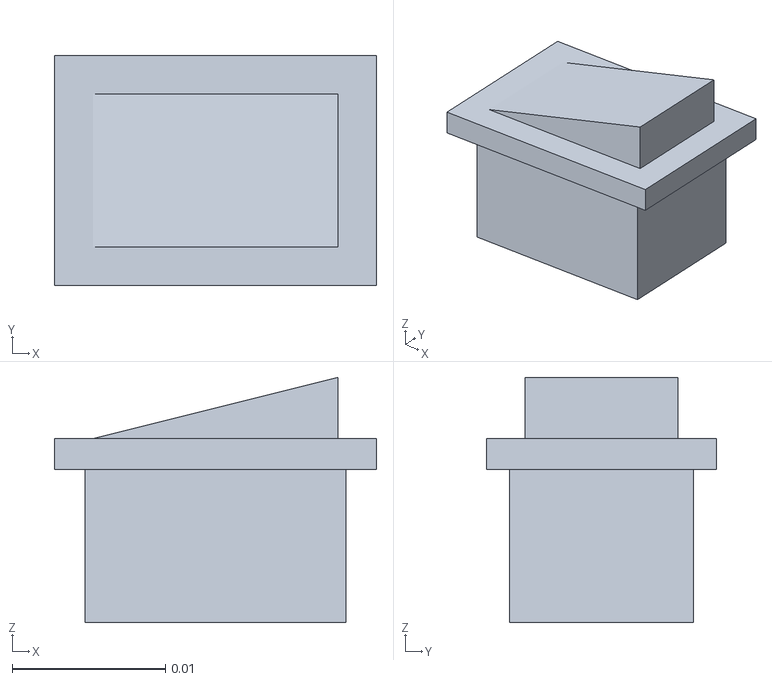
[picture p9: CAD file, 2026-10-16]
model/microban_pl/assets/switch.stl
0.021 x 0.015 x 0.016
