hijimasa/reduced-dof-humanoid/model/parts_derived/radius_long.step

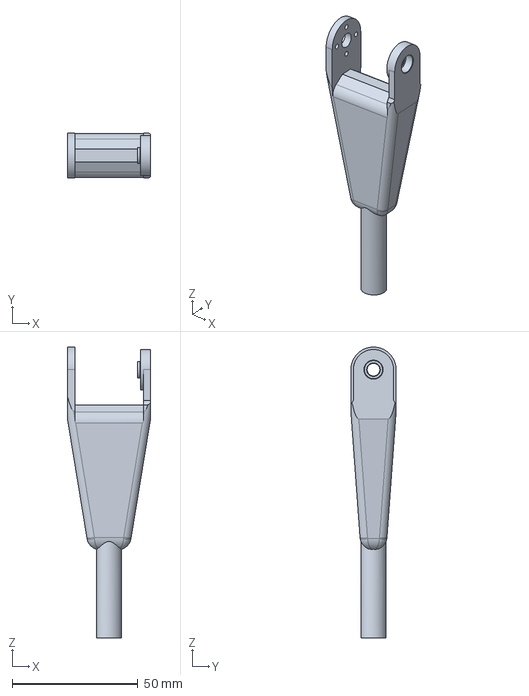
[picture p10: CAD file, 2026-10-17]
model/parts_derived/radius_long.step
33.0 x 18.0 x 115.5 mm
