hijimasa/reduced-dof-humanoid/model/microban_pl/assets/xl330_without_horn.stl

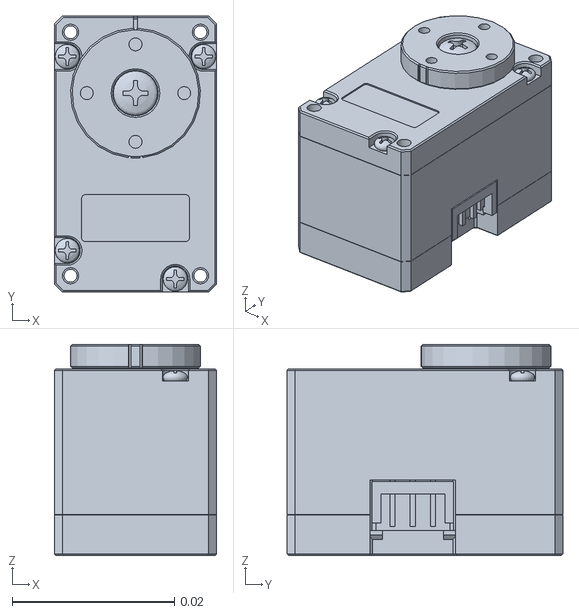
[picture p11: CAD file, 2026-10-16]
model/microban_pl/assets/xl330_without_horn.stl
0.02 x 0.034 x 0.026
