hijimasa/reduced-dof-humanoid/model/parts/knee_axle_cap.stl

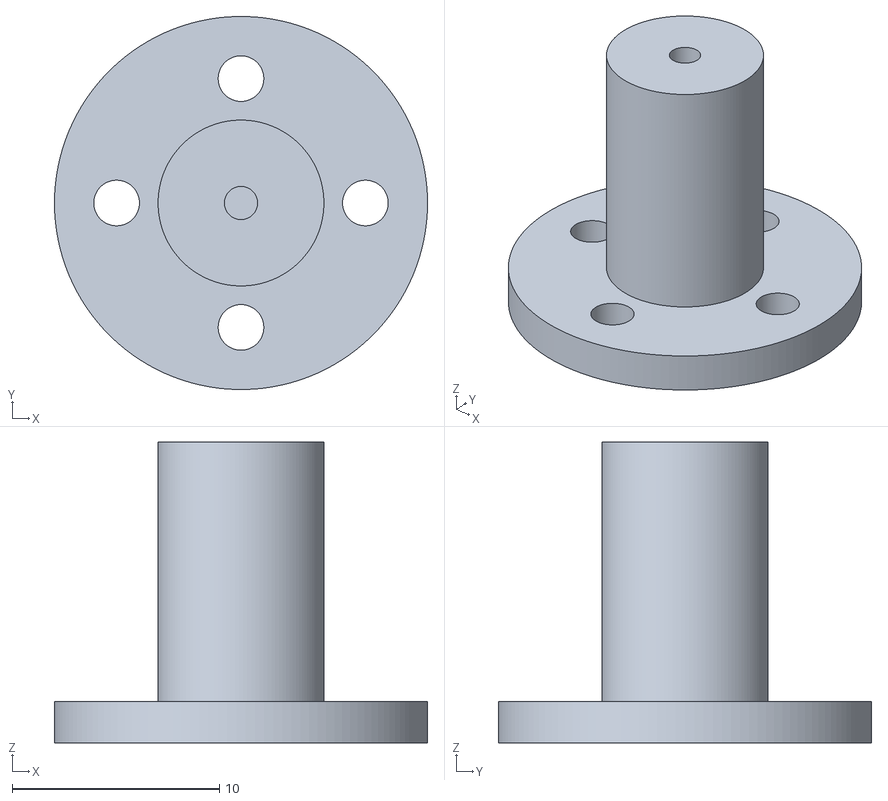
[picture p12: CAD file, 2026-10-17]
model/parts/knee_axle_cap.stl
18.0 x 18.0 x 14.5
