hijimasa/reduced-dof-humanoid/model/parts_derived/hip_block_integrated_right.step

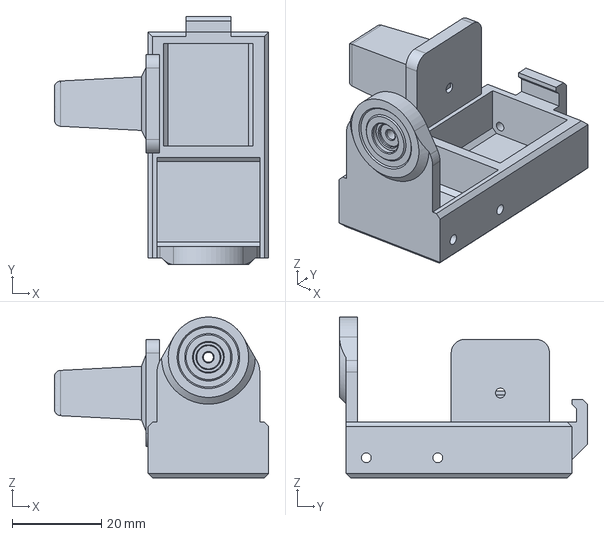
[picture p13: CAD file, 2026-10-17]
model/parts_derived/hip_block_integrated_right.step
48.0 x 55.5 x 36.0 mm
