hijimasa/reduced-dof-humanoid/model/microban_pl/assets/dc15_a01_horn_idle2_dummy.stl

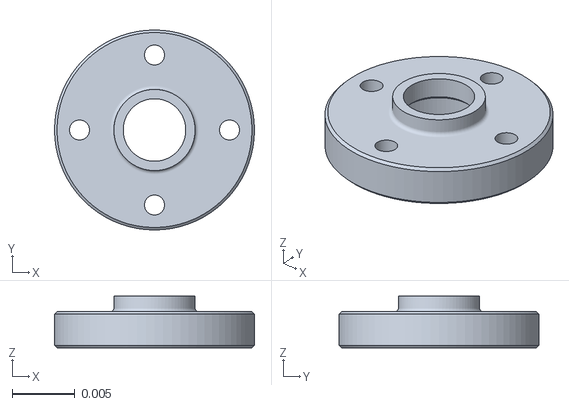
[picture p14: CAD file, 2026-10-16]
model/microban_pl/assets/dc15_a01_horn_idle2_dummy.stl
0.016 x 0.016 x 0.00415
