hijimasa/reduced-dof-humanoid/model/parts/knee_yoke_right.stl

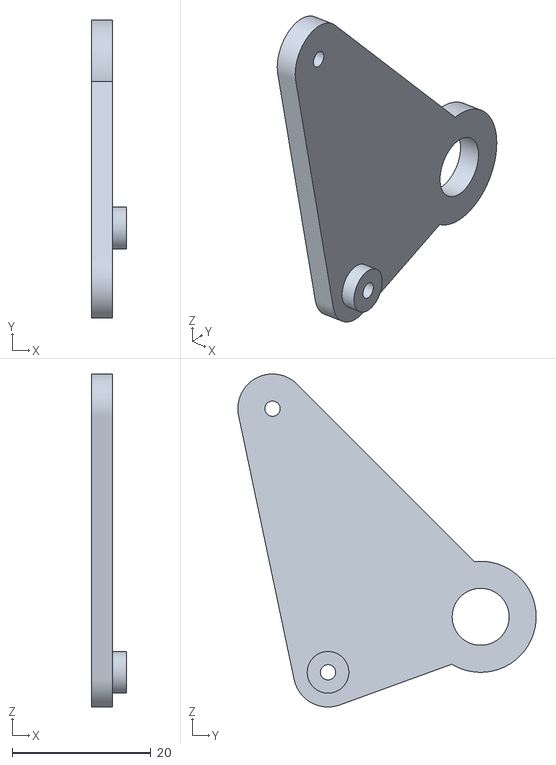
[picture p15: CAD file, 2026-10-17]
model/parts/knee_yoke_right.stl
5.00 x 43.0 x 48.0
