hijimasa/reduced-dof-humanoid/model/microban_pl/assets/hip__configuration_right.stl

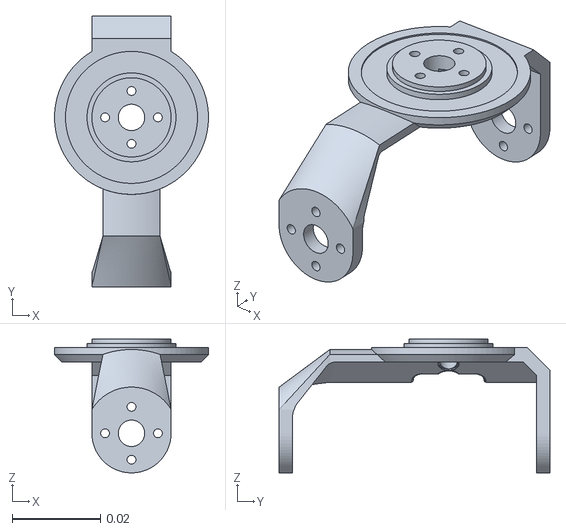
[picture p16: CAD file, 2026-10-16]
model/microban_pl/assets/hip__configuration_right.stl
0.035 x 0.0615 x 0.0304
