hijimasa/reduced-dof-humanoid/model/microban_pl/assets/arm_bearing_support__configuration_right.stl

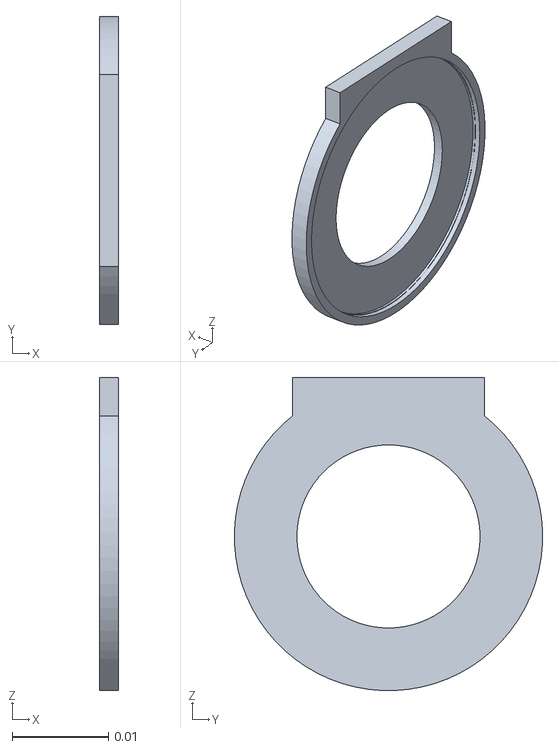
[picture p17: CAD file, 2026-10-16]
model/microban_pl/assets/arm_bearing_support__configuration_right.stl
0.002 x 0.032 x 0.0325
