hijimasa/reduced-dof-humanoid/model/parts/standoff_shank_ankle.stl

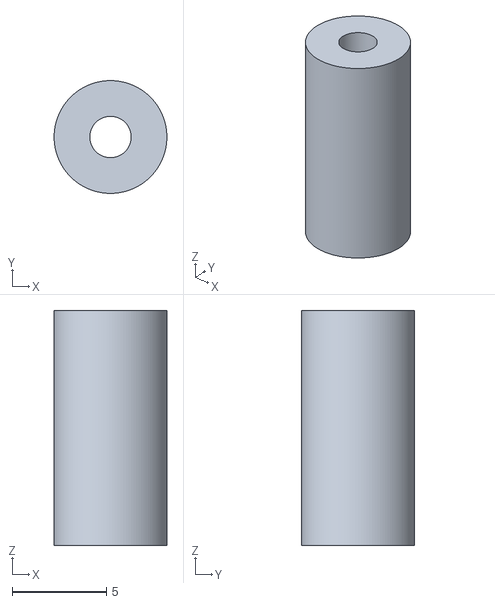
[picture p18: CAD file, 2026-10-17]
model/parts/standoff_shank_ankle.stl
6.00 x 6.00 x 12.5
