hijimasa/reduced-dof-humanoid/model/parts_derived/foot_sole80.step

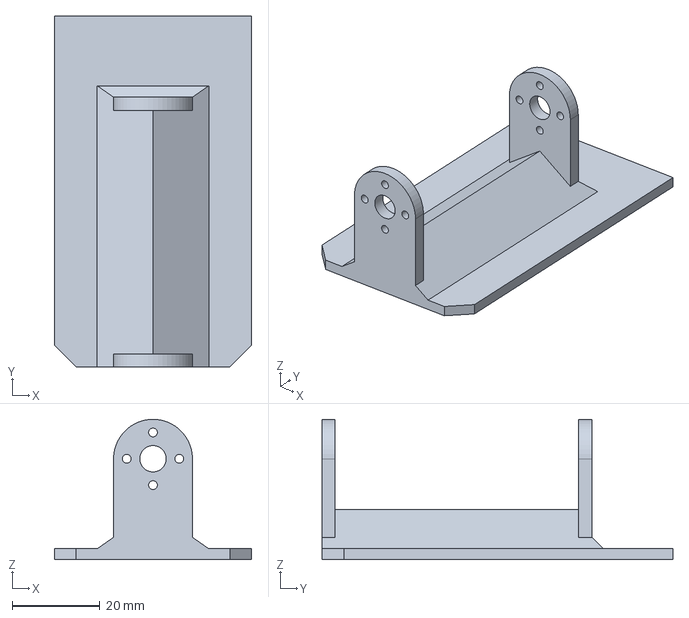
[picture p19: CAD file, 2026-10-17]
model/parts_derived/foot_sole80.step
45.0 x 80.0 x 32.0 mm
