hijimasa/reduced-dof-humanoid/model/microban_pl/assets/femur__configuration_right.stl

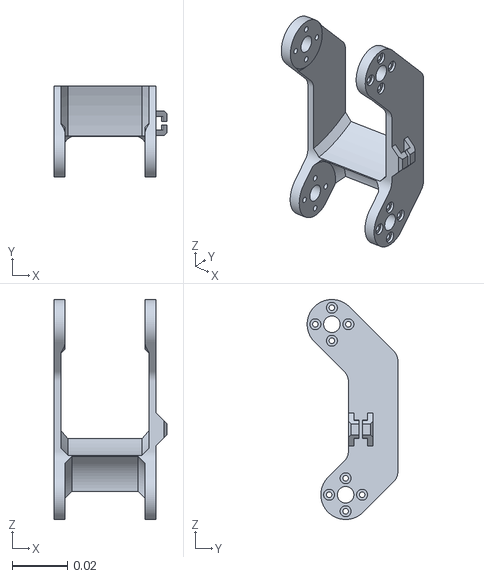
[picture p20: CAD file, 2026-10-16]
model/microban_pl/assets/femur__configuration_right.stl
0.041 x 0.033 x 0.08
