hijimasa/reduced-dof-humanoid/model/parts/xl330_dummy_hip_yaw.stl

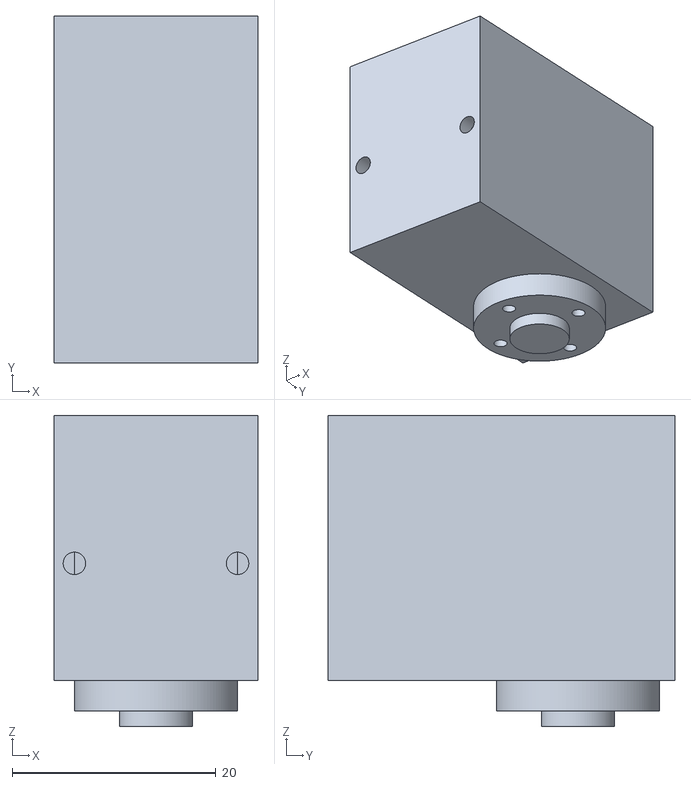
[picture p21: CAD file, 2026-10-17]
model/parts/xl330_dummy_hip_yaw.stl
20.0 x 34.0 x 30.5
