hijimasa/reduced-dof-humanoid/model/parts_derived/head_integrated.step

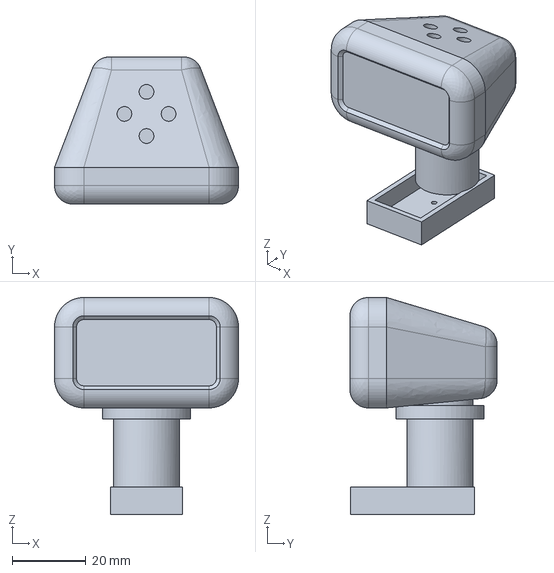
[picture p22: CAD file, 2026-10-17]
model/parts_derived/head_integrated.step
50.0 x 40.0 x 58.9 mm
