hijimasa/reduced-dof-humanoid/model/microban_pl/assets/dc15_a01_idle_cap_dummy.stl

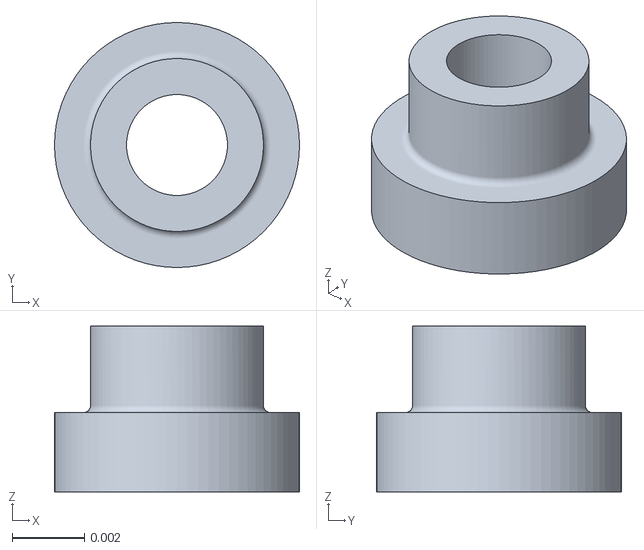
[picture p23: CAD file, 2026-10-16]
model/microban_pl/assets/dc15_a01_idle_cap_dummy.stl
0.0068 x 0.0068 x 0.0046
