hijimasa/reduced-dof-humanoid/model/microban_pl/assets/foot__configuration_right.stl

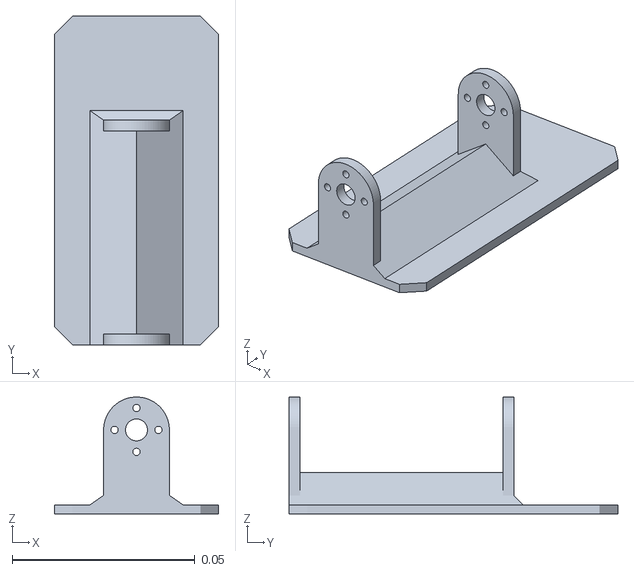
[picture p24: CAD file, 2026-10-16]
model/microban_pl/assets/foot__configuration_right.stl
0.045 x 0.09 x 0.032
