hijimasa/reduced-dof-humanoid/model/microban_pl/assets/battery.stl

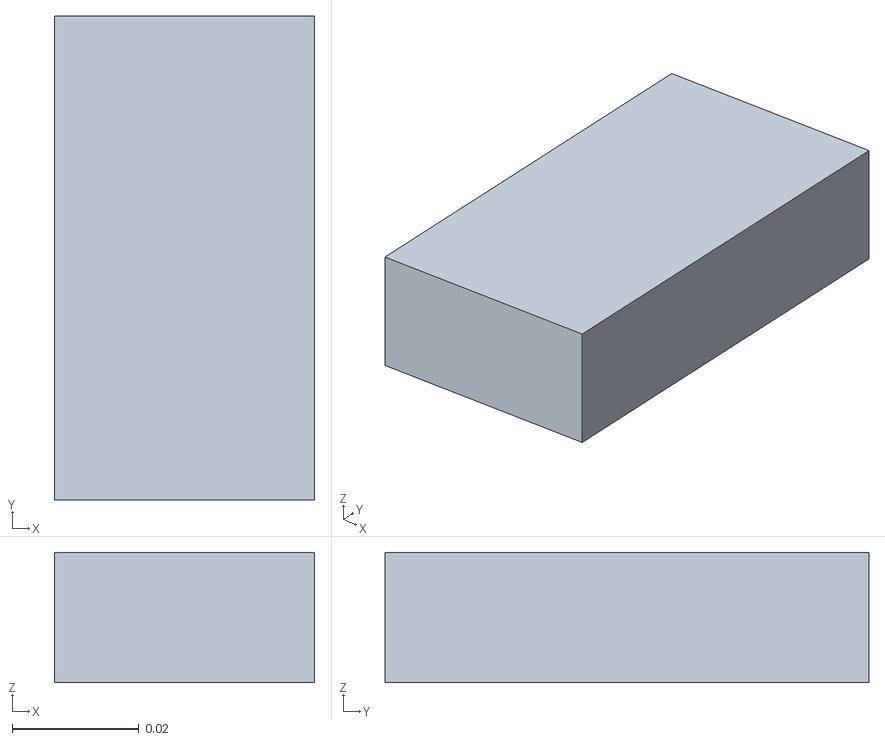
[picture p25: CAD file, 2026-10-16]
model/microban_pl/assets/battery.stl
0.041 x 0.0763 x 0.0205
