hijimasa/reduced-dof-humanoid/model/parts/xl330_dummy_ankle_hinge.stl

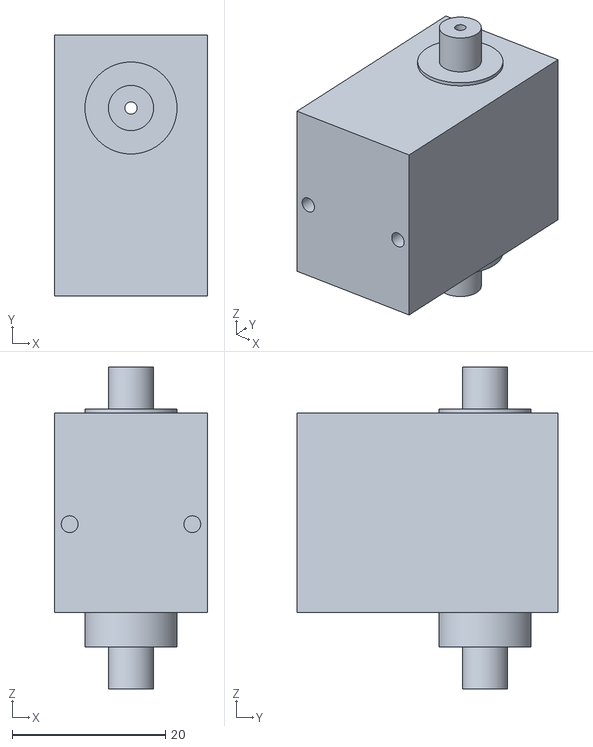
[picture p26: CAD file, 2026-10-17]
model/parts/xl330_dummy_ankle_hinge.stl
20.0 x 34.0 x 42.0
