hijimasa/reduced-dof-humanoid/model/microban_pl/assets/pelvis__configuration_right.stl

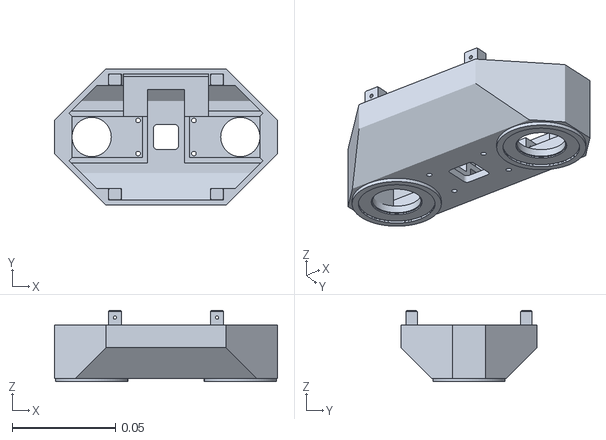
[picture p27: CAD file, 2026-10-16]
model/microban_pl/assets/pelvis__configuration_right.stl
0.108 x 0.066 x 0.0345
