hijimasa/reduced-dof-humanoid/model/parts/shank_bar.stl

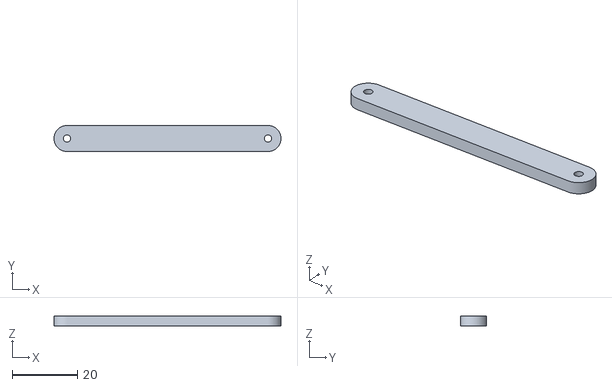
[picture p28: CAD file, 2026-10-17]
model/parts/shank_bar.stl
69.7 x 8.00 x 3.00
