hijimasa/reduced-dof-humanoid/model/microban_pl/assets/shoulder.stl

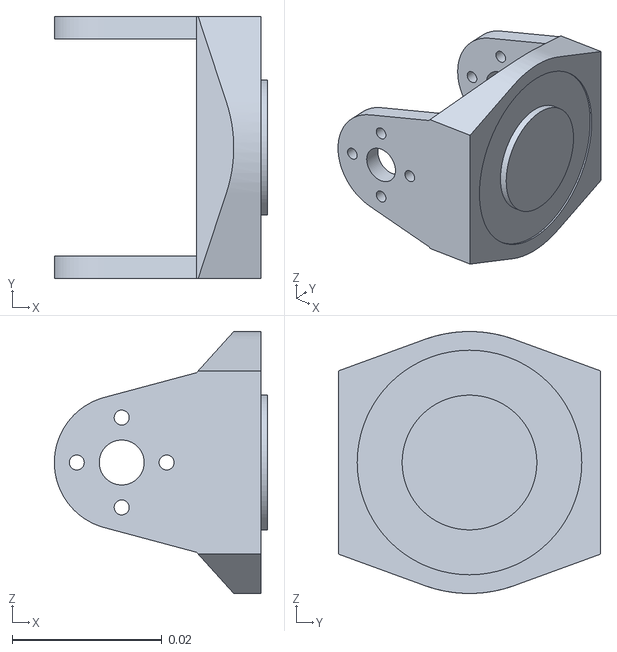
[picture p29: CAD file, 2026-10-16]
model/microban_pl/assets/shoulder.stl
0.0285 x 0.035 x 0.035
