hijimasa/reduced-dof-humanoid/model/microban_pl/assets/humerus.stl

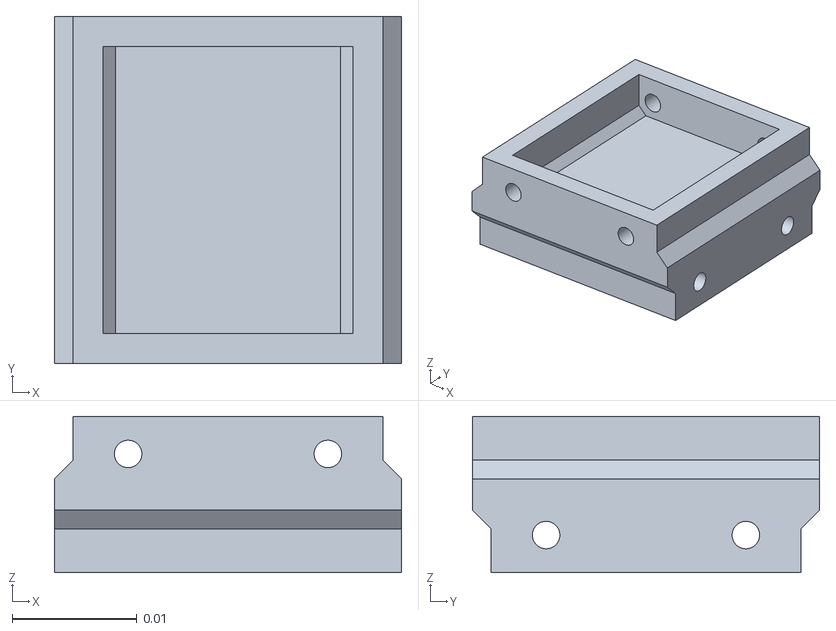
[picture p30: CAD file, 2026-10-16]
model/microban_pl/assets/humerus.stl
0.0278 x 0.0278 x 0.0125
