hijimasa/reduced-dof-humanoid/model/microban_pl/assets/ankle_dbl_block__configuration_right.stl

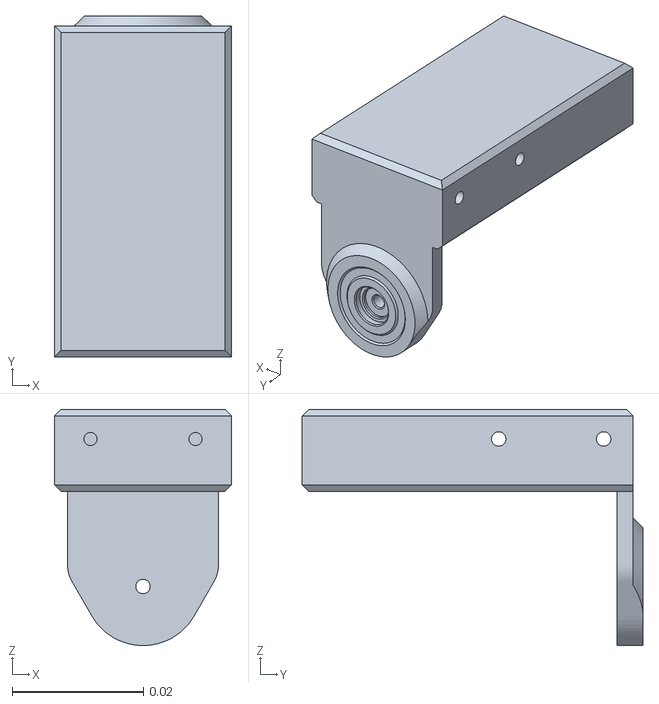
[picture p31: CAD file, 2026-10-16]
model/microban_pl/assets/ankle_dbl_block__configuration_right.stl
0.027 x 0.052 x 0.036
