hijimasa/reduced-dof-humanoid/model/microban_pl/assets/spacer__configuration_right.stl

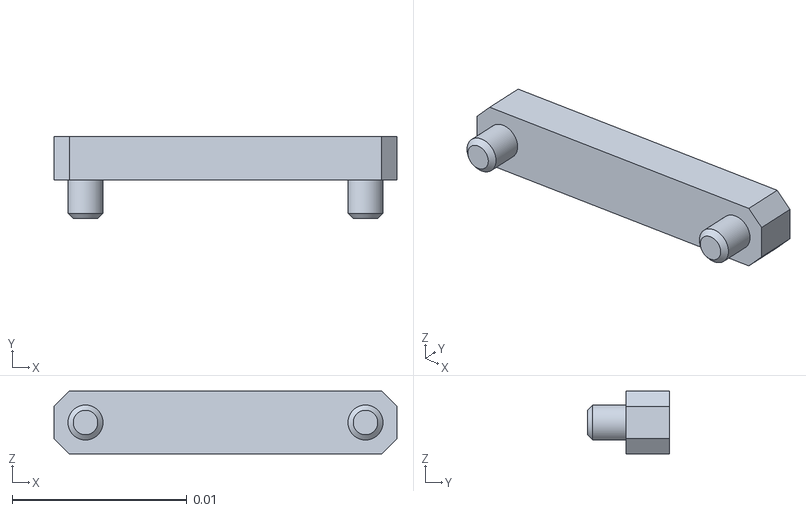
[picture p32: CAD file, 2026-10-16]
model/microban_pl/assets/spacer__configuration_right.stl
0.0196 x 0.0047 x 0.0036
