hijimasa/reduced-dof-humanoid/model/microban_pl/assets/head__configuration_right.stl

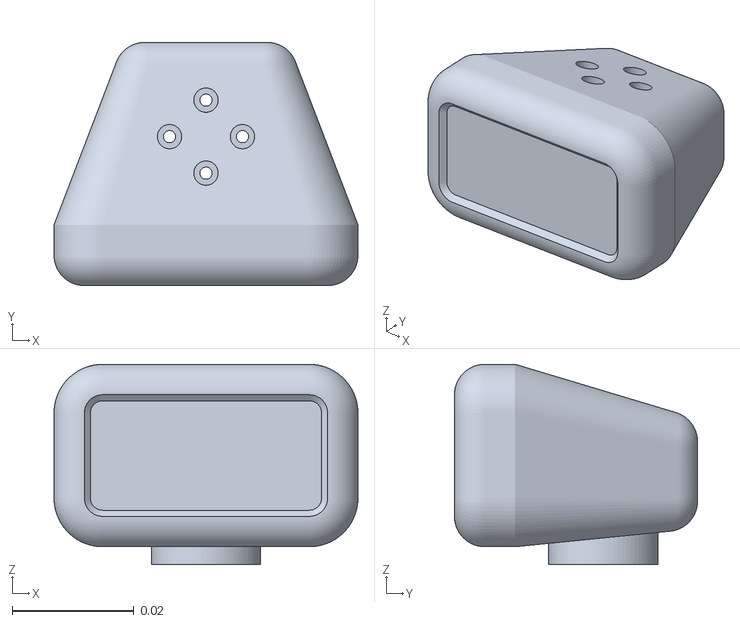
[picture p33: CAD file, 2026-10-16]
model/microban_pl/assets/head__configuration_right.stl
0.05 x 0.04 x 0.0329
