hijimasa/reduced-dof-humanoid/model/microban_pl/assets/tibia__configuration_left.stl

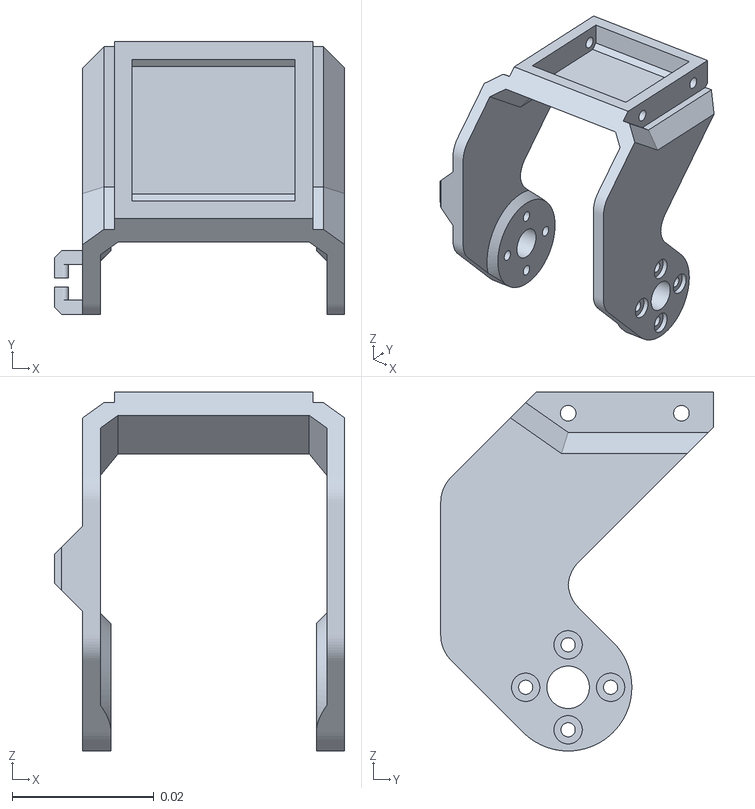
[picture p34: CAD file, 2026-10-16]
model/microban_pl/assets/tibia__configuration_left.stl
0.041 x 0.0385 x 0.0507
