hijimasa/reduced-dof-humanoid/model/microban_pl/assets/hip_dbl_block__configuration_left.stl

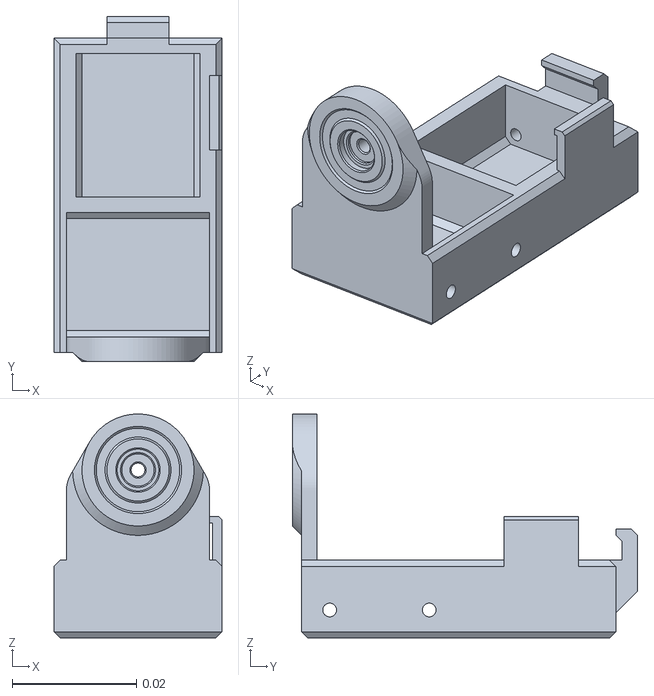
[picture p35: CAD file, 2026-10-16]
model/microban_pl/assets/hip_dbl_block__configuration_left.stl
0.027 x 0.0555 x 0.036
