hijimasa/reduced-dof-humanoid/model/microban_pl/assets/bts2_m2_6x8.stl

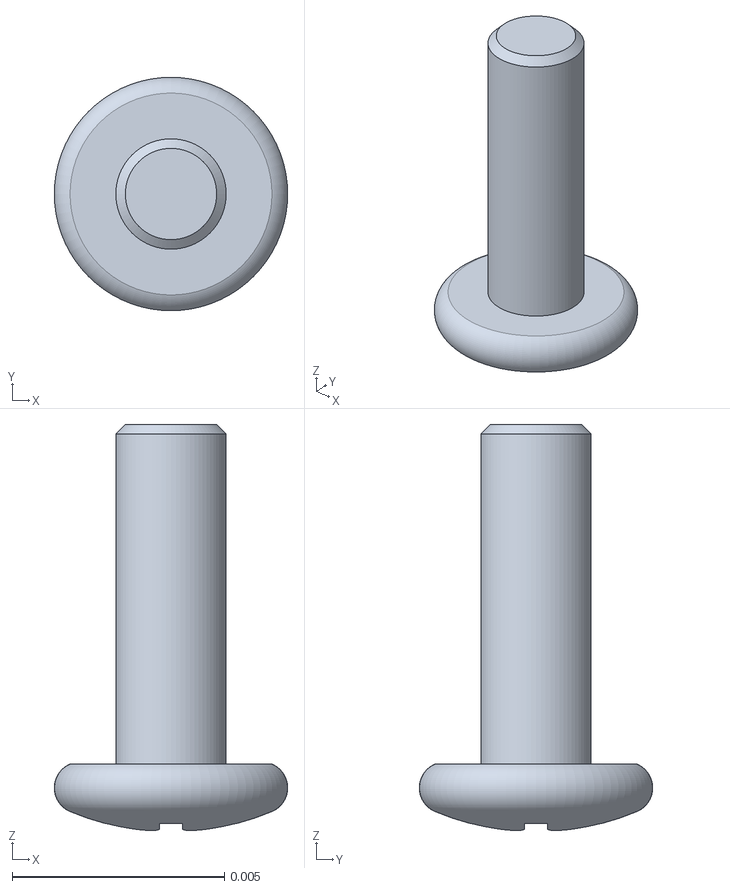
[picture p36: CAD file, 2026-10-16]
model/microban_pl/assets/bts2_m2_6x8.stl
0.0055 x 0.0055 x 0.00957
