hijimasa/reduced-dof-humanoid/model/microban_pl/assets/chest__configuration_right.stl

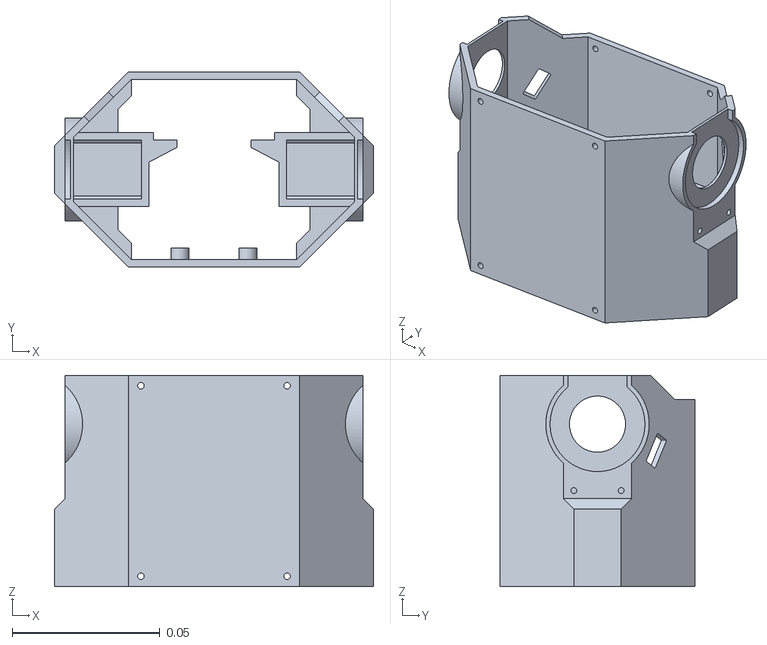
[picture p37: CAD file, 2026-10-16]
model/microban_pl/assets/chest__configuration_right.stl
0.108 x 0.066 x 0.0715
