hijimasa/reduced-dof-humanoid/model/microban_pl/assets/trunk_top__configuration_right.stl

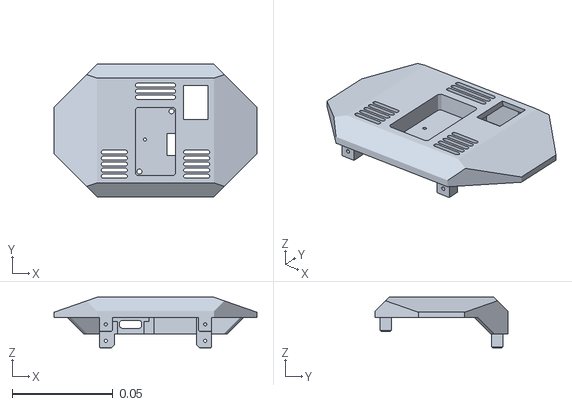
[picture p38: CAD file, 2026-10-16]
model/microban_pl/assets/trunk_top__configuration_right.stl
0.101 x 0.066 x 0.0252
