hijimasa/reduced-dof-humanoid/model/microban_pl/assets/xl330.stl

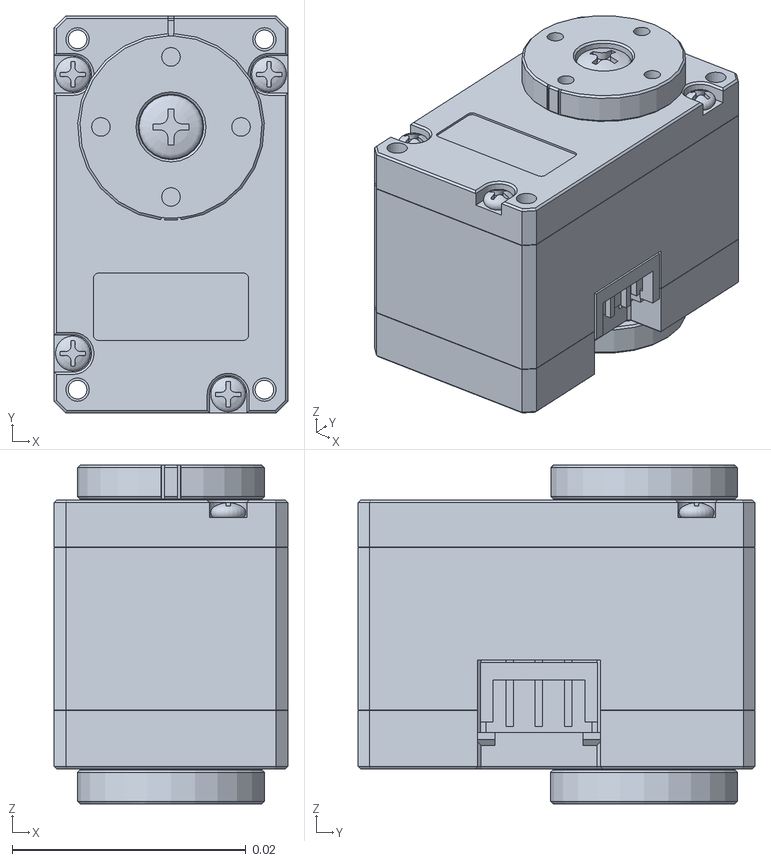
[picture p39: CAD file, 2026-10-16]
model/microban_pl/assets/xl330.stl
0.02 x 0.034 x 0.029
