hijimasa/reduced-dof-humanoid/(list of files, cad)

Other CAD files:
model/parts/shoulder_arm_simple_right.step
model/parts_derived/hip_block_integrated_left.step
model/parts/knee_yoke_left.stl
model/parts_derived/ankle_block_integrated_left.step
model/parts/xl330_dummy_shoulder_roll_right.stl
model/parts/xl330_dummy_shoulder_roll_left.stl
model/microban_pl/assets/femur__configuration_left.stl
model/parts/thigh_bar.stl
model/microban_pl/assets/hip_dbl_block__configuration_right.stl
model/microban_pl/assets/tibia__configuration_right.stl
model/parts/shoulder_arm_simple_left.stl
model/parts/shoulder_arm_simple_right.stl
model/parts_derived/ankle_block_integrated_left.stl
model/parts_derived/ankle_block_integrated_right.stl
model/parts_derived/foot_sole80.stl
model/parts_derived/head_integrated.stl
model/parts_derived/hip_block_integrated_left.stl
model/parts_derived/hip_block_integrated_right.stl
model/parts_derived/radius_long.stl
