hijimasa/reduced-dof-humanoid/tools/make_microban_pl.py

#!/usr/bin/env python3
# Copyright 2026 Masaaki Hijikata
# SPDX-License-Identifier: Apache-2.0
"""Generate the parallel-link (passive ankle pitch) variant of Microban's MJCF.

Input is Rhoban/microban's ``src/model/mjcf/robot.xml`` (or an already converted
file). Output is a MuJoCo model in which, per leg, two parallelogram linkages keep
the foot parallel to the pelvis in the pitch direction, so the ankle-pitch servo is
removed, and the head is fixed to the trunk (19 -> 16 actuators; ``--neck-motor``
keeps the neck servo). The mechanism is the one used by the ``ashigaru``
robot: knee block parallel to the pelvis, rear links closing the loops with
``<connect>`` equality constraints. The knee actuator angle is therefore measured
against the pelvis, not against the thigh.

usage:
  python3 tools/make_microban_pl.py <robot.xml> <out.xml> [--naming upstream|lme]
                                    [--keep-motor] [--back 0.020] [--tilt 0.005]
                                    [--scene out_scene.xml]
"""
import argparse, os, re, sys
import numpy as np
import xml.etree.ElementTree as ET

# ---------------------------------------------------------------- naming
UP2LME = {"head": "c_neck_zy"}
for side, s in (("right", "r"), ("left", "l")):
    UP2LME.update({
        f"{side}_shoulder_pitch": f"{s}_shoulder_yp", f"{side}_shoulder_roll": f"{s}_shoulder_xr",
        f"{side}_elbow": f"{s}_elbow_yp",             f"{side}_hip_yaw": f"{s}_hipjoint_zy",
        f"{side}_hip_roll": f"{s}_hipjoint_xr",       f"{side}_hip_pitch": f"{s}_hipjoint_yp",
        f"{side}_knee": f"{s}_knee_yp",               f"{side}_ankle_pitch": f"{s}_ankle_yp",
        f"{side}_ankle_roll": f"{s}_ankle_xr",
        # passive joints added by this script. Their LME names must NOT appear in
        # LegacyMotionEditor's JOINT_TO_MERIDIM table: "r_knee_yp_1" is an alias there
        # for the knee's own Meridim slot, and LME publishing the passive knee-block
        # angle into it made the knee servo flip between two targets at 100 Hz.
        f"{side}_knee_block": f"{s}_kneeblock_yp", f"{side}_thigh_rear": f"{s}_thighlink_yp",
        f"{side}_shank_rear": f"{s}_shanklink_yp",
    })
LME2UP = {v: k for k, v in UP2LME.items()}

# ---------------------------------------------------------------- geometry
# Both link bars sit BEHIND the leg (toward -x of the robot), the pivots tilted so that the
# parallelogram singularity is pushed away from the postures that matter (defaults):
#   thigh linkage: pivots 22 mm back, 8 mm DOWN  -> singular at hip ext +69.4deg, hip flex -110.6deg
#   shank linkage: pivots 30 mm back, 30 mm UP   -> singular at knee flex +135deg, knee ext -45deg
# (positive hip/knee pitch = link swings backward, as in the original model)
LEG = {  # local frames: right femur +x = world back, +y = world up; left femur mirrored
    "right": dict(hipblock="hip_block__configuration_right", femur="femur__configuration_right",
                  tibia="tibia__configuration_right", ankle="ankle_block__configuration_left", sx=+1),
    "left":  dict(hipblock="hip_block__configuration_left",  femur="femur__configuration_left",
                  tibia="tibia__configuration_left",  ankle="ankle_block__configuration_right", sx=-1),
}
# Joint ranges follow from the linkage: a parallelogram degenerates when its link lies
# along the line between its two pivots, i.e. at 90deg +- atan(tilt/back) from straight.
# Thigh: rear pivot DOWN -> flexion singular at 90 + a, extension at 90 - a.
# Shank: rear pivot UP   -> flexion singular at 90 + a, extension at 90 - a.
# Both ranges keep RANGE_MARGIN degrees clear of the singularity.
RANGE_MARGIN = 8.0
HIP_FLEX_LIMIT = 100.0   # deg; with the thigh bar behind the thigh the bar never nears the knee axle stub inside the
                         # range, so this cap is above the singularity-based limit and inactive
XL330_TORQUE = 0.52          # N*m, XL330-M288-T stall torque at 5 V
XL330_MASS = 0.023           # kg
SLIM_ANKLE_MASS = 0.025      # kg: ankle block minus the XL330 that is no longer there

def q2m(q):
    w, x, y, z = q
    return np.array([[1-2*(y*y+z*z), 2*(x*y-z*w), 2*(x*z+y*w)],
                     [2*(x*y+z*w), 1-2*(x*x+z*z), 2*(y*z-x*w)],
                     [2*(x*z-y*w), 2*(y*z+x*w), 1-2*(x*x+y*y)]])
def vec(s): return np.array([float(t) for t in s.split()])
def fmt(a): return " ".join(f"{float(t):.6g}" for t in np.atleast_1d(a))

DUMMY_MASS = 0.008   # kg, a printed XL330-sized block (20 x 34 x 26 mm, 2 mm shell: 7.7 cm3)
# Integrated printed parts (tools/make_parts.py with Microban's cad/step): volumes from CadQuery at an
# effective 1.0 g/cm3 (PLA, 3 walls, ~40 % infill). The originals they absorb are taken out at the same density.
PLA_G_PER_CM3 = 1.0
ANKLE_CAP_CM3, ANKLE_INTEGRATED_CM3 = 9.2, 17.3        # ankle_dbl_block -> ankle_block_integrated_{side}
HUMERUS_CM3, SHOULDER_CM3, SHOULDER_ARM_CM3 = 4.3, 8.8, 13.5   # humerus plate + shoulder bracket -> shoulder_arm_simple_{side} (CAD volume from make_parts.py)
HIP_EAR_CM3 = 3.6                                               # the pivot support grown out of hip_block_integrated_{side}
NECK_POST_CM3 = 6.4                                             # the neck grown out of head_integrated (head itself keeps the upstream mass)


PART_HOOK = {"fn": None}   # set in main() when --parts is given: (body, name, pos, quat) -> adds a mesh geom


def dummy_block(body, pos, quat, part_name=None):
    """Visual + mass of a printed XL330-shaped spacer in a servo's old place: same envelope,
    so the original brackets bolt on unchanged and a real servo can go back in later."""
    if PART_HOOK["fn"] and part_name:
        PART_HOOK["fn"](body, part_name, vec(pos), vec(quat))
    else:
        ET.SubElement(body, "geom", {"class": "visual", "type": "box", "size": "0.010 0.017 0.013",
                                     "pos": fmt(vec(pos) + q2m(vec(quat)) @ np.array([0, -0.0075, -0.0065])),
                                     "quat": quat, "rgba": "0.85 0.6 0.25 1"})
    ine = body.find("inertial")
    m0 = float(ine.get("mass")); m1 = m0 + DUMMY_MASS
    ine.set("mass", f"{m1:.6f}")


def slim_ankle(body, h, integrated=None):
    """Take the ankle-pitch servo out of the ankle block.

    Upstream, the block carries two XL330s: the ankle-pitch servo (its horn on the
    tibia) and the ankle-roll servo. With the pitch joint passive, the first one and
    the idler horn opposite it go, and the U-bracket that wrapped the servo becomes a
    short clevis around the hinge. Its collision box keeps the bracket's plane and
    thickness but is cut to +-h about the axis. Mass: 47 g -> SLIM_ANKLE_MASS.
    """
    for g in list(body.findall("geom")):
        at = g.attrib
        if at.get("mesh") == "xl330":
            body.remove(g)
            if integrated is None or not PART_HOOK["fn"]:
                dummy_block(body, at.get("pos"), at.get("quat", "1 0 0 0"), "xl330_dummy_ankle_hinge")
        elif at.get("mesh", "").startswith("ankle_dbl_block") and integrated and PART_HOOK["fn"]:
            # the cap and the hinge body become one printed part (parts_derived/ankle_block_integrated_*)
            body.remove(g); PART_HOOK["fn"](body, f"ankle_block_integrated_{integrated}", vec(at["pos"]), vec(at.get("quat", "1 0 0 0")))
        elif at.get("mesh") in ("dc15_a01_horn_idle2_dummy", "bts2_m2_6x8", "dc15_a01_idle_cap_dummy"):
            body.remove(g)
        elif at.get("class") == "collision":
            sx, sy, sz = (float(v) for v in at["size"].split())
            px, py, pz = (float(v) for v in at["pos"].split())
            at["size"] = fmt((sx, h, sz)); at["pos"] = fmt((px, np.sign(py) * h, pz))
    ine = body.find("inertial")
    scale = SLIM_ANKLE_MASS / float(ine.get("mass"))   # dummy_block already added its 8 g above
    if integrated and PART_HOOK["fn"]:
        m1 = SLIM_ANKLE_MASS + (ANKLE_INTEGRATED_CM3 - ANKLE_CAP_CM3) * PLA_G_PER_CM3 / 1000
    else:
        m1 = SLIM_ANKLE_MASS + DUMMY_MASS
    ine.set("mass", f"{m1:.6f}")
    ine.set("fullinertia", " ".join(f"{float(v) * scale:.4e}" for v in ine.get("fullinertia").split()))


def header_comments(path):
    """Top-level comments before <mujoco> (ElementTree drops them)."""
    txt = open(path, encoding="utf-8").read()
    i = txt.find("<mujoco")
    return txt[:i].strip() + "\n" if i > 0 else ""

def main():
    ap = argparse.ArgumentParser(description=__doc__, formatter_class=argparse.RawDescriptionHelpFormatter)
    ap.add_argument("src"); ap.add_argument("out")
    ap.add_argument("--naming", choices=["upstream", "lme"], default="upstream",
                    help="joint/actuator names: Microban originals or LegacyMotionEditor convention")
    ap.add_argument("--keep-motor", action="store_true", help="keep <motor> actuators instead of <position>")
    ap.add_argument("--neck-motor", action="store_true",
                    help="keep the neck (head yaw) servo; by default the head is fixed to the trunk")
    ap.add_argument("--back", type=float, default=0.022,
                    help="thigh linkage: pivot offset behind the joint axes [m]; NEGATIVE = in front. Default 32 mm "
                         "behind (the arms are abducted, so the old reason for a front bar, the hanging forearm, is gone; "
                         "behind the thigh the hip-side pivot sits beside the hip bracket's rear skirt on a short lug)")
    ap.add_argument("--tilt", type=float, default=0.008,
                    help="thigh linkage: pivot DOWN by this much [m]; NEGATIVE = up. A rear linkage needs its pivots DOWN "
                         "(12 mm): extension singularity at 69.4 deg (the get-ups use 55), flexion at 110.6")
    ap.add_argument("--shank-back", type=float, default=0.030,
                    help="shank linkage: rear pivot offset [m] (25 mm clears the tibia's rear edge and the ankle-roll servo)")
    ap.add_argument("--shank-tilt", type=float, default=0.030,
                    help="shank linkage: rear pivot UP by this much [m] (lifts the ankle pivot above the foot and the roll servo)")
    ap.add_argument("--link-x", type=float, default=0.0365,
                    help="lateral centre of the THIGH bar [m] from the leg centre plane (36.5 mm = 35..38, outside the knee "
                         "yoke and its axle stub, so the rear bar can sweep past the knee axis near the extension limit). The shank bar sits one plane further out "
                         "(--shank-link-x) so the two can cross at deep hip flexion.")
    ap.add_argument("--shank-link-x", type=float, default=0.0275,
                    help="lateral centre of the SHANK bar [m] (27.5 mm = 26..29); the knee yoke plate is outside it")
    ap.add_argument("--arm-abduct", type=float, default=30.0,
                    help="12/14-servo models: fixed outward angle [deg] of the arm, built into the printed block that "
                         "replaces the shoulder-roll servo. With the arm straight down the hanging forearm sits right "
                         "over the knee yoke / link bars (22..32 mm from the leg centre); 30 deg moves the elbow 26 mm "
                         "outboard so the forearm can be bent forward like a walking human. 0 = arm at the side")
    ap.add_argument("--dummies", action="store_true",
                    help="use the XL330-shaped spacer blocks at the ankle hinge, shoulder roll and neck instead of the "
                         "integrated parts (ankle_block_integrated, upper_arm_integrated, neck_post). The hip-yaw "
                         "position always keeps the servo-shaped block so the 14-servo upgrade stays a drop-in")
    ap.add_argument("--derived", default=None,
                    help="directory of the parts derived from Microban's CAD, relative to meshdir (default: the "
                         "--parts directory with 'parts' replaced by 'parts_derived')")
    ap.add_argument("--hip-flex-limit", type=float, default=HIP_FLEX_LIMIT,
                    help="cap on hip flexion [deg] from the thigh bar / knee axle stub clearance (85 with the Ø8 "
                         "printed stub; an M3 bolt axle would allow ~96)")
    ap.add_argument("--keep-ankle-servo", action="store_true",
                    help="keep the ankle-pitch servo's geometry and mass in the ankle block (by default "
                         "it is removed and the bracket shrunk to a clevis, which is what lets the knee fold deeper)")
    ap.add_argument("--clevis", type=float, default=0.006,
                    help="half-height of the slimmed ankle bracket's collision box [m]")
    ap.add_argument("--scene", help="also write a viewer scene (floor + standing keyframe) to this path")
    ap.add_argument("--dof", type=int, choices=[16, 14, 12], default=16,
                    help="16: passive ankle pitch + fixed head. 14: additionally no shoulder roll "
                         "(legs 5x2 with hip yaw, arms 2x2 -- the chosen layout). 12: no hip yaw either")
    ap.add_argument("--meshdir", help="override the compiler meshdir written into the output")
    ap.add_argument("--elbow-flexion-only", action="store_true",
                    help="limit the elbow to forward flexion (-125..+10 deg, negative = flexion). The default "
                         "keeps Microban's own symmetric +-125 deg: the forearm clears the upper arm either "
                         "way, and the prone get-up that was found robust pushes with the elbow bent backward")
    ap.add_argument("--sole-length", type=float, default=0.080,
                    help="length [m] of the sole's ground-contact plate (ROBO-ONE Light: <= 55%% of the leg "
                         "length; Microban's 90 mm sole on this 146 mm leg needs <= 80.4 mm, so the default is "
                         "80 mm; 0 keeps Microban's 90 mm). Only the collision plate changes; the foot mesh "
                         "is left as is, the printed foot has to be shortened to match.")
    ap.add_argument("--parts", default="",
                    help="directory of the printed-part STLs (tools/make_parts.py), as a path RELATIVE TO MESHDIR; "
                         "when given, the links, knee yoke, axle caps and spacer blocks are drawn with those meshes "
                         "instead of boxes (which LegacyMotionEditor's preview cannot show)")
    ap.add_argument("--forearm-ext", type=float, default=0.04,
                    help="lengthen each forearm by this much [m] (default 40 mm: KXR / Robovie-nano proportions; "
                         "ROBO-ONE Light allows 26 cm from the shoulder and wants the hands 50 mm up while walking, "
                         "the hands then hang 86 mm up with straight arms in the walking crouch). With --parts the "
                         "forearm mesh becomes parts_derived/radius_long (a Ø10 rod with a rounded end), 4 g per 40 mm; "
                         "0 keeps Microban's forearm")
    a = ap.parse_args()

    head = header_comments(a.src)
    tree = ET.parse(a.src); root = tree.getroot()
    bodies = {b.get("name"): b for b in root.iter("body")}

    # detect source naming and build the rename table toward the requested naming
    src_is_lme = any(j.get("name") == "r_hipjoint_yp" for j in root.iter("joint"))
    if a.naming == "lme":
        rename = {} if src_is_lme else UP2LME
        name = lambda up: UP2LME[up]
    else:
        rename = LME2UP if src_is_lme else {}
        name = lambda up: up
    for el in root.iter():
        if el.tag in ("joint", "motor", "position", "general"):
            for attr in ("name", "joint"):
                if el.get(attr) in rename:
                    el.set(attr, rename[el.get(attr)])

    model_name = {16: "microban_pl", 14: "microban_pl14", 12: "microban_pl12"}[a.dof] + ("_lme" if a.naming == "lme" else "")
    root.set("model", model_name)

    asset = root.find("asset")
    PART_MESHES = ("thigh_bar", "shank_bar", "knee_yoke_right", "knee_yoke_left", "knee_axle_cap",
                   "xl330_dummy_shoulder_roll_right", "xl330_dummy_shoulder_roll_left", "xl330_dummy_neck", "xl330_dummy_hip_yaw", "xl330_dummy_ankle_hinge")
    PART_MESHES += ("shoulder_arm_simple_right", "shoulder_arm_simple_left")
    DERIVED_MESHES = ("ankle_block_integrated_right", "ankle_block_integrated_left", "hip_block_integrated_right", "hip_block_integrated_left", "head_integrated", "radius_long", "foot_sole80")
    NO_COLLISION = DERIVED_MESHES + ("shoulder_arm_simple_right", "shoulder_arm_simple_left")   # radius_long and foot_sole80 collide through the capsule / cut plates   # a convex hull of these would be meaningless
    if a.parts:
        for nm in PART_MESHES:
            ET.SubElement(asset, "mesh", {"name": f"part_{nm}", "file": f"{a.parts}/{nm}.stl", "scale": "0.001 0.001 0.001"})
        derived = a.derived or a.parts.replace("parts", "parts_derived")
        for nm in DERIVED_MESHES:
            ET.SubElement(asset, "mesh", {"name": f"part_{nm}", "file": f"{derived}/{nm}.stl", "scale": "0.001 0.001 0.001"})

    PART_GREEN, DUMMY_AMBER = "0.15 0.75 0.3 1", "0.9 0.65 0.2 1"

    def part(body, nm, pos, quat, rgba=None):
        rgba = rgba or (DUMMY_AMBER if "dummy" in nm else PART_GREEN)
        ET.SubElement(body, "geom", {"class": "visual", "type": "mesh", "mesh": f"part_{nm}", "pos": fmt(pos),
                                     "quat": fmt(quat), "rgba": rgba})
        if nm == "knee_axle_cap":
            # flange + stub as two cylinders: one convex hull of the cap would be a cone that reaches
            # from the Ø18 flange into the thigh-bar plane and reports a phantom 5 mm interference
            Rq = q2m(np.asarray(quat))
            for r, h, zc in ((0.009, 0.001, 0.001), (0.004, 0.00625, 0.00825)):
                ET.SubElement(body, "geom", {"class": "collision", "type": "cylinder", "size": fmt((r, h)),
                                             "pos": fmt(np.asarray(pos) + Rq @ np.array([0, 0, zc])), "quat": fmt(quat)})
        elif "dummy" not in nm and nm not in NO_COLLISION:   # the mechanism parts also collide (convex hull), so interference is simulated
            ET.SubElement(body, "geom", {"class": "collision", "type": "mesh", "mesh": f"part_{nm}", "pos": fmt(pos),
                                         "quat": fmt(quat)})
    PART_HOOK["fn"] = part if a.parts else None

    dflt = root.find("default")
    pcls = ET.SubElement(dflt, "default", {"class": "passive"})
    ET.SubElement(pcls, "joint", {"damping": "0.005", "frictionloss": "0.001", "armature": "0.0001"})

    eq = root.find("equality")
    if eq is None:
        eq = ET.SubElement(root, "equality")

    def inertial(el, mass, pos, diag):
        ET.SubElement(el, "inertial", {"pos": fmt(pos), "mass": f"{mass}", "diaginertia": fmt(diag)})
    def rod(el, v, bar="thigh_bar", lateral=None):
        # printed bars, pin to pin, in sagittal planes offset laterally (local z is the pitch
        # axis = world +y): thigh bars on both sides at +-link_x, the shank bar outboard only
        ang = np.arctan2(v[1], v[0]); q = (np.cos(ang / 2), 0.0, 0.0, np.sin(ang / 2))
        offsets = lateral if lateral is not None else (c_z + out_z * a.link_x,)
        if a.parts:
            for zx in offsets:   # STL: centred at the origin along x, 3 mm thick in +z
                part(el, bar, v / 2 + np.array([0, 0, zx - 0.0015]), q)
            return
        for zx in offsets:
            ET.SubElement(el, "geom", {"class": "visual", "type": "box",
                                       "size": fmt((np.linalg.norm(v) / 2 + 0.004, 0.004, 0.0015)),
                                       "pos": fmt(v / 2 + np.array([0, 0, zx])), "quat": fmt(q),
                                       "rgba": "0.15 0.75 0.3 1"})

    def singularities(back, tilt):
        """(forward, backward) swing angle at which the parallelogram folds flat, for a pivot
        offset `back` behind and `tilt` below the joint axis (either may be negative)."""
        fwd, up = -back, -tilt
        angs = [np.degrees(np.arctan2(sx * fwd, -(sx * up))) for sx in (1, -1)]   # from 'down' toward 'forward'
        return max(angs), -min(angs)
    f1, b1 = singularities(a.back, a.tilt); f2, b2 = singularities(a.shank_back, -a.shank_tilt)   # shank tilt is UP
    # hip flexion is also capped at HIP_FLEX_LIMIT: beyond ~90 deg the front thigh bar sweeps across the
    # knee axis and would touch the Ø8 knee axle stub (the get-ups use at most 37 deg of hip flexion)
    HIP_RANGE = (-np.radians(min(f1 - RANGE_MARGIN, a.hip_flex_limit)), np.radians(b1 - RANGE_MARGIN))    # hip: +ve = thigh back
    KNEE_RANGE = (-np.radians(f2 - RANGE_MARGIN), np.radians(b2 - RANGE_MARGIN))   # knee: +ve = shank back

    for side, L in LEG.items():
        hipblock, femur, tibia, ankle = (bodies[L[k]] for k in ("hipblock", "femur", "tibia", "ankle"))
        if not a.keep_ankle_servo:
            slim_ankle(ankle, a.clevis, None if a.dummies else side)
        d1 = np.array([L["sx"] * a.back, -L["sx"] * a.tilt, 0.0])               # thigh rear pivot (back, down)
        d2 = np.array([L["sx"] * a.shank_back, +L["sx"] * a.shank_tilt, 0.0])   # shank rear pivot (back, up)
        v1 = vec(tibia.get("pos"))          # hip pitch axis -> knee axis (femur frame)
        v2 = vec(ankle.get("pos"))          # knee axis -> ankle axis (tibia frame)
        tq = tibia.get("quat", "1 0 0 0").replace("-0", "0").split()
        assert tq == ["1", "0", "0", "0"], f"{L['tibia']}: quat must be identity"

        # The femur/tibia body origins sit on the INBOARD clevis plate, 14.5 mm from the leg's
        # centre plane, so lateral placements are measured from the knee servo's centre:
        # c_z in the femur body frame (local z = pitch axis = world +y), x_c in the femur
        # mesh (= Onshape leg) frame.
        sg = next(x for x in tibia.findall("geom") if x.get("mesh") == "xl330")
        # leg centre = midway between the horn face (mesh z -22.5) and the idler face (+6.5)
        p_servo = v1 + vec(sg.get("pos")) + q2m(vec(sg.get("quat", "1 0 0 0"))) @ np.array([0, -0.0075, -0.0080])
        c_z = float(p_servo[2])
        fg = next(x for x in femur.findall("geom") if x.get("mesh") == L["femur"])
        fgp, fgq = vec(fg.get("pos")), vec(fg.get("quat", "1 0 0 0")); R_fg = q2m(fgq)
        x_c = float((R_fg.T @ (p_servo - fgp))[0])
        knee_mesh = R_fg.T @ (v1 - fgp)
        out_sign = 1.0 if side == "right" else -1.0        # mesh +x is world -y: outboard on the right, inboard on the left
        out_z = -1.0 if side == "right" else 1.0           # femur body +z is world +y

        # knee block: passive hinge, stays parallel to the pelvis
        femur.remove(tibia)
        kb = ET.Element("body", {"name": f"{side}_knee_block", "pos": fmt(v1)})
        ET.SubElement(kb, "joint", {"name": name(f"{side}_knee_block"), "type": "hinge",
                                    "axis": "0 0 1", "class": "passive"})
        inertial(kb, 0.006, (0, 0, 0), (2e-7, 2e-7, 2e-7))
        if a.parts:
            # the parts are modelled in the Onshape leg frame with the leg centre at x = 0; that
            # frame is the femur mesh geom's frame shifted to the actual centre x_c
            part(kb, f"knee_yoke_{side}", fgp + R_fg @ np.array([x_c, 0, 0]) - v1, fgq)
            # the thigh bar's upper pivot is grown out of the hip bracket: swap its mesh for the
            # integrated one (same STEP frame), unless the spacer-block variant is wanted
            if not a.dummies:
                for g in list(hipblock.findall("geom")):
                    if g.get("mesh", "").startswith("hip_dbl_block"):
                        hipblock.remove(g); part(hipblock, f"hip_block_integrated_{side}", vec(g.get("pos")), vec(g.get("quat", "1 0 0 0")))
                        hi = hipblock.find("inertial"); hi.set("mass", f"{float(hi.get('mass')) + HIP_EAR_CM3 * PLA_G_PER_CM3 / 1000:.6f}")
            # axle cap: flange on the outer plate face (centre +- 18.5 mm), stub pointing outboard
            cap_pos = fgp + R_fg @ np.array([x_c + out_sign * 0.0185, knee_mesh[1], knee_mesh[2]])
            r2 = np.sqrt(0.5); q_rot = np.array([r2, 0, out_sign * r2, 0])        # cap +z -> mesh +-x
            w1, x1, y1, z1 = fgq; w2, x2, y2, z2 = q_rot
            cap_q = (w1*w2 - x1*x2 - y1*y2 - z1*z2, w1*x2 + x1*w2 + y1*z2 - z1*y2,
                     w1*y2 - x1*z2 + y1*w2 + z1*x2, w1*z2 + x1*y2 - y1*x2 + z1*w2)
            part(femur, "knee_axle_cap", cap_pos, cap_q)
        # box placeholders (shown when no --parts): a bar behind the knee carrying both
        # rear-link pivots and spanning the two link planes, plus an outboard arm
        mid = (d1 + d2) / 2
        if not a.parts:
            ET.SubElement(kb, "geom", {"class": "visual", "type": "box",
                                       "size": fmt((0.004, abs(d2[1] - d1[1]) / 2 + 0.006, a.link_x + 0.0015)),
                                       "pos": fmt(mid + np.array([0, 0, c_z])), "rgba": "0.15 0.75 0.3 1"})
            ET.SubElement(kb, "geom", {"class": "visual", "type": "box",
                                       "size": fmt((abs(mid[0]) / 2 + 0.006, 0.005, 0.0015)),
                                       "pos": fmt((mid[0] / 2, mid[1] / 2, c_z + out_z * 0.022)), "rgba": "0.15 0.75 0.3 1"})
        tibia.set("pos", "0 0 0"); tibia.set("quat", "1 0 0 0")
        kb.append(tibia)
        sr = ET.SubElement(kb, "body", {"name": f"{side}_shank_rear", "pos": fmt(d2)})
        ET.SubElement(sr, "joint", {"name": name(f"{side}_shank_rear"), "type": "hinge",
                                    "axis": "0 0 1", "class": "passive"})
        inertial(sr, 0.002, v2 / 2, (6.4e-7, 6.4e-7, 2e-8)); rod(sr, v2, "shank_bar", (c_z + out_z * a.shank_link_x,))
        femur.append(kb)

        fpos, fq = vec(femur.get("pos")), vec(femur.get("quat"))
        tr = ET.SubElement(hipblock, "body", {"name": f"{side}_thigh_rear",
                                              "pos": fmt(fpos + q2m(fq) @ d1), "quat": femur.get("quat")})
        ET.SubElement(tr, "joint", {"name": name(f"{side}_thigh_rear"), "type": "hinge",
                                    "axis": "0 0 1", "class": "passive"})
        inertial(tr, 0.002, v1 / 2, (6.4e-7, 6.4e-7, 2e-8)); rod(tr, v1, "thigh_bar", (c_z + out_z * a.link_x,))

        for j in root.iter("joint"):
            n = j.get("name")
            if n == name(f"{side}_ankle_pitch"):
                j.set("class", "passive"); j.attrib.pop("range", None)
                if a.naming == "lme":
                    j.set("name", f"{side[0]}_anklepassive_yp")   # "r_ankle_yp" is Meridim slot 69 in LME
            elif n == name(f"{side}_hip_pitch"):
                j.set("range", fmt(HIP_RANGE))
            elif n == name(f"{side}_knee"):
                j.set("range", fmt(KNEE_RANGE))

        ET.SubElement(eq, "connect", {"name": f"{side}_thigh_loop", "body1": f"{side}_knee_block",
                                      "body2": f"{side}_thigh_rear", "anchor": fmt(d1),
                                      "solref": "0.005 1", "solimp": "0.99 0.999 0.001"})
        ET.SubElement(eq, "connect", {"name": f"{side}_shank_loop", "body1": L["ankle"],
                                      "body2": f"{side}_shank_rear", "anchor": fmt(-d2),
                                      "solref": "0.005 1", "solimp": "0.99 0.999 0.001"})

    # fixed head: the ROBO-ONE rules only require a head, not an actuated one
    removed_joints = {name("right_ankle_pitch"), name("left_ankle_pitch")}
    if not a.neck_motor:
        for b in root.iter("body"):
            for j in list(b.findall("joint")):
                if j.get("name") == name("head"):
                    b.remove(j); removed_joints.add(name("head"))
        # the neck servo itself sits in the trunk, just under the head: drop it and its mass
        trunk = bodies["trunk"]
        for g in list(trunk.findall("geom")):
            if g.get("mesh", "").startswith("xl330") and abs(vec(g.get("pos"))[2] - 0.1195) < 1e-3:
                trunk.remove(g)
                if a.dummies or not a.parts:
                    dummy_block(trunk, g.get("pos"), g.get("quat", "1 0 0 0"), "xl330_dummy_neck")
                else:
                    # head and neck post become one printed part, drawn in the head body in the head's own frame
                    for hb in root.iter("body"):
                        if hb.get("name", "").startswith("head"):
                            for hg in list(hb.findall("geom")):
                                if hg.get("mesh", "").startswith("head"):
                                    hb.remove(hg); part(hb, "head_integrated", vec(hg.get("pos")), vec(hg.get("quat", "1 0 0 0")))
                            hi = hb.find("inertial"); hi.set("mass", f"{float(hi.get('mass')) + NECK_POST_CM3 * PLA_G_PER_CM3 / 1000:.6f}")
        ine = trunk.find("inertial")
        m0 = float(ine.get("mass")); m1 = m0 - XL330_MASS
        ine.set("mass", f"{m1:.6f}")
        ine.set("fullinertia", " ".join(f"{float(v) * m1 / m0:.5e}" for v in ine.get("fullinertia").split()))

    parent_of = {c.get("name"): p for p in root.iter("body") for c in p.findall("body")}
    humerus_pose0 = {n: (vec(b.get("pos")), vec(b.get("quat", "1 0 0 0"))) for n, b in bodies.items() if n.startswith("humerus")}
    drop = []
    if a.dof <= 14:
        drop.append("shoulder_roll")   # joint on the humerus, servo at the top of the humerus
    if a.dof == 12:
        drop.append("hip_yaw")         # joint on the hip bracket, servo in the bottom of the trunk
    for side in ("right", "left"):
        for base in drop:
            for b in root.iter("body"):
                for j in list(b.findall("joint")):
                    if j.get("name") == name(f"{side}_{base}"):
                        b.remove(j); removed_joints.add(name(f"{side}_{base}"))
                        if base == "shoulder_roll" and a.arm_abduct:
                            # The printed block that replaces the shoulder-roll servo holds the arm
                            # abducted by a fixed angle, so a forward-bent forearm swings clear of
                            # the link stack outboard of the knee. Bake the angle into the humerus
                            # frame (the joint sat at the body origin, axis in body coordinates).
                            # Microban's roll range is -180..0 on the right and 0..180 on the left:
                            # abduction is the direction the range allows.
                            sgn = -1.0 if side == "right" else 1.0
                            ax = vec(j.get("axis", "0 0 1")); ax = ax / np.linalg.norm(ax)
                            h = np.radians(a.arm_abduct) / 2 * sgn
                            qr = np.array([np.cos(h), *(np.sin(h) * ax)])
                            w1, x1, y1, z1 = vec(b.get("quat", "1 0 0 0")); w2, x2, y2, z2 = qr
                            b.set("quat", fmt((w1*w2 - x1*x2 - y1*y2 - z1*z2, w1*x2 + x1*w2 + y1*z2 - z1*y2,
                                               w1*y2 - x1*z2 + y1*w2 + z1*x2, w1*z2 + x1*y2 - y1*x2 + z1*w2)))
    if a.dof == 12:
        # Hip yaw servos: one XL330 each side at y = +-36 mm in the bottom of the trunk.
        # Without them each hip bracket bolts straight to the trunk.
        trunk = bodies["trunk"]
        n_removed = 0
        for g in list(trunk.findall("geom")):
            pz = vec(g.get("pos", "0 0 0"))
            if g.get("mesh", "").startswith("xl330") and abs(abs(pz[1]) - 0.036) < 1e-3 and abs(pz[2] - 0.0065) < 1e-3:
                trunk.remove(g); n_removed += 1; dummy_block(trunk, g.get("pos"), g.get("quat", "1 0 0 0"), "xl330_dummy_hip_yaw")
        assert n_removed == 2, f"expected the two hip-yaw servos in the trunk, found {n_removed}"
        ine = trunk.find("inertial")
        m0 = float(ine.get("mass")); m1 = m0 - 2 * XL330_MASS
        ine.set("mass", f"{m1:.6f}")
        ine.set("fullinertia", " ".join(f"{float(v) * m1 / m0:.5e}" for v in ine.get("fullinertia").split()))
    if a.dof <= 14:
        # Shoulder roll servos: the XL330 at the top of each humerus (the other one in the
        # humerus is the elbow's). The humerus bolts to the shoulder bracket, arm at the side.
        for hb in ("humerus__configuration_right", "humerus__configuration_left"):
            hum = bodies[hb]; n_removed = 0
            for g in list(hum.findall("geom")):
                if g.get("mesh") == "xl330" and abs(vec(g.get("pos"))[2] + 0.0065) < 1e-3:
                    hum.remove(g); n_removed += 1
                    if a.dummies or not a.parts:
                        dummy_block(hum, g.get("pos"), g.get("quat", "1 0 0 0"), "xl330_dummy_shoulder_roll_" + hb.rsplit("_", 1)[1])
            assert n_removed == 1, f"{hb}: shoulder-roll servo not found"
            ine = hum.find("inertial")
            m0 = float(ine.get("mass")); m1 = m0 - XL330_MASS
            if not (a.dummies or not a.parts):
                # shoulder bracket, humerus plate and a column in the servo's place become one printed part
                # (parts/shoulder_arm_simple_*), drawn in the shoulder body in the humerus STEP frame
                # as it was before the abduction was baked into the humerus quat (the part has the turn built in)
                side = hb.rsplit("_", 1)[1]; shoulder = parent_of[hb]
                hp0, hq0 = humerus_pose0[hb]
                for g in list(hum.findall("geom")):
                    if g.get("mesh") == "humerus":
                        hum.remove(g); gp, gq = vec(g.get("pos")), vec(g.get("quat", "1 0 0 0"))
                        w1, x1, y1, z1 = hq0; w2, x2, y2, z2 = gq
                        qq = (w1*w2 - x1*x2 - y1*y2 - z1*z2, w1*x2 + x1*w2 + y1*z2 - z1*y2,
                              w1*y2 - x1*z2 + y1*w2 + z1*x2, w1*z2 + x1*y2 - y1*x2 + z1*w2)
                        part(shoulder, f"shoulder_arm_simple_{side}", hp0 + q2m(hq0) @ gp, qq)
                for g in list(shoulder.findall("geom")):
                    if g.get("mesh") == "shoulder":
                        shoulder.remove(g)
                si = shoulder.find("inertial"); si.set("mass", f"{float(si.get('mass')) + (SHOULDER_ARM_CM3 - SHOULDER_CM3 - HUMERUS_CM3) * PLA_G_PER_CM3 / 1000:.6f}")
            ine.set("mass", f"{m1:.6f}")
            ine.set("fullinertia", " ".join(f"{float(v) * m1 / m0:.5e}" for v in ine.get("fullinertia").split()))

    if a.forearm_ext > 0:
        # The radius runs along its local -y from the elbow; the upstream hand collision
        # cylinder is centred 67 mm down it. Add a capsule from there to 67 mm + ext.
        for rb in ("radius", "radius_2"):
            rad = bodies[rb]
            sy = -1.0 if rb == "radius" else 1.0
            zc = 0.0135 * (-sy)                  # the upstream hand cylinder sits at z +0.0135 (right) / -0.0135 (left)
            y0, y1 = sy * 0.067, sy * (0.067 + a.forearm_ext)
            ET.SubElement(rad, "geom", {"class": "collision", "type": "capsule", "size": "0.005",
                                        "fromto": fmt((0, y0, zc)) + " " + fmt((0, y1, zc))})
            swapped = False
            if a.parts and not a.dummies and abs(a.forearm_ext - 0.04) < 1e-6:
                # the printed forearm: Microban's radius with the rod grown out of it (parts_derived/radius_long)
                for g in list(rad.findall("geom")):
                    if g.get("mesh") == "radius":
                        rad.remove(g); part(rad, "radius_long", vec(g.get("pos")), vec(g.get("quat", "1 0 0 0"))); swapped = True
            if not swapped:
                ET.SubElement(rad, "geom", {"class": "visual", "type": "capsule", "size": "0.005", "rgba": "0.3 0.3 0.32 1",
                                            "fromto": fmt((0, y0, zc)) + " " + fmt((0, y1, zc))})
            ine = rad.find("inertial")
            m0 = float(ine.get("mass")); madd = 0.004 * a.forearm_ext / 0.040     # Ø10 PLA rod: ~3 cm3 per 40 mm, 4 g with the fillet
            c0 = vec(ine.get("pos")); c1 = np.array([0, (y0 + y1) / 2, zc])
            ine.set("pos", fmt((c0 * m0 + c1 * madd) / (m0 + madd))); ine.set("mass", f"{m0 + madd:.6f}")
            fi = [float(v) for v in ine.get("fullinertia").split()]
            L = a.forearm_ext; I = madd * L * L / 12
            fi[0] += I; fi[2] += I          # rod inertia about the two axes across it
            ine.set("fullinertia", " ".join(f"{v:.5e}" for v in fi))

    if a.elbow_flexion_only:
        for j in root.iter("joint"):
            if j.get("name") in (name("right_elbow"), name("left_elbow")):
                j.set("range", fmt((-2.18166, 0.17453)))   # flexion only, +10 deg of hyperextension

    if a.sole_length > 0:
        # The foot's ground contact is two overlapping plates (45 x 80 and 35 x 90 mm) plus
        # four thin corner pads; the length runs along the foot body's local +z = forward.
        # The ankle bracket sits over the rear part of the plate, so the printed part is
        # shortened at the TOE only (model/parts_derived/foot_sole80): keep the heel end,
        # pull the toe end back.
        for fb in ("foot", "foot_2"):
            plates = [g for g in bodies[fb].findall("geom")
                      if g.get("class") == "collision" and g.get("type") == "box" and vec(g.get("size"))[1] > 0.02]
            toe_old = max(vec(g.get("pos"))[2] + vec(g.get("size"))[1] for g in plates)
            heel = min(vec(g.get("pos"))[2] - vec(g.get("size"))[1] for g in plates)
            toe_new = heel + a.sole_length
            if toe_new >= toe_old:
                continue
            for g in bodies[fb].findall("geom"):
                if g.get("class") != "collision" or g.get("type") != "box": continue
                sz = vec(g.get("size")); ps = vec(g.get("pos"))
                if sz[1] > 0.02:                                   # plates: keep the heel end, cut the toe
                    front = min(ps[2] + sz[1], toe_new); back = ps[2] - sz[1]
                    sz[1] = (front - back) / 2; ps[2] = (front + back) / 2
                    g.set("size", fmt(sz)); g.set("pos", fmt(ps))
                elif ps[2] > 0.042:                                # toe pads follow the new toe
                    ps[2] -= toe_old - toe_new; g.set("pos", fmt(ps))
            if a.parts and not a.dummies and abs(a.sole_length - 0.080) < 1e-6:
                # draw the shortened printed foot (parts_derived/foot_sole80, same frame as the upstream
                # mesh) in place of Microban's foot, so the changed part shows green like the others
                for g in list(bodies[fb].findall("geom")):
                    if g.get("mesh", "").startswith("foot"):
                        bodies[fb].remove(g); part(bodies[fb], "foot_sole80", vec(g.get("pos")), vec(g.get("quat", "1 0 0 0")))

    # actuators: drop ankle pitch (and neck), motor -> position unless asked otherwise
    act = root.find("actuator")
    ankle_joints = removed_joints
    kept = []
    for el in list(act):
        act.remove(el)
        if el.get("joint") in ankle_joints:
            continue
        if el.tag == "motor" and not a.keep_motor:
            el = ET.Element("position", {"name": el.get("name"), "joint": el.get("joint"),
                                         "kp": "50", "dampratio": "1",
                                         "forcerange": f"{-XL330_TORQUE} {XL330_TORQUE}"})
        kept.append(el)
    act.extend(kept)

    if a.meshdir:
        root.find("compiler").set("meshdir", a.meshdir)
    ET.indent(root, space="  ")
    body = ET.tostring(root, encoding="unicode")
    note = (f"<!--\n{model_name}: Microban with parallel-link legs (passive ankle pitch).\n"
            f"Derived from Rhoban/microban src/model/mjcf/robot.xml by tools/make_microban_pl.py\n"
            f"(dof={a.dof}, elbow={"flexion-only" if a.elbow_flexion_only else "free"}, naming={a.naming}, thigh back/tilt={a.back}/{a.tilt}, shank back/tilt={a.shank_back}/{a.shank_tilt}, link_x={a.link_x}, fixed_head={not a.neck_motor}, slim_ankle={not a.keep_ankle_servo}, integrated_parts={not a.dummies and bool(a.parts)}, forearm_ext={a.forearm_ext}, arm_abduct={a.arm_abduct if a.dof <= 14 else "n/a"}).\n"
            f"Hip range {np.degrees(HIP_RANGE[0]):.0f}..{np.degrees(HIP_RANGE[1]):.0f} deg, knee {np.degrees(KNEE_RANGE[0]):.0f}..{np.degrees(KNEE_RANGE[1]):.0f} deg (pelvis-relative). See NOTICE.md for attribution.\n-->\n")
    os.makedirs(os.path.dirname(os.path.abspath(a.out)), exist_ok=True)
    with open(a.out, "w", encoding="utf-8") as f:
        f.write(head + note + body + "\n")
    print("wrote", a.out)

    if a.scene:
        write_scene(a.out, a.scene)

def write_scene(model_path, scene_path):
    import mujoco
    m = mujoco.MjModel.from_xml_path(model_path); d = mujoco.MjData(m); mujoco.mj_forward(m, d)
    # lowest point of the collision geometry at qpos0 (box corners exact, others by bounding sphere)
    zmin = 1e9
    for g in range(m.ngeom):
        if m.geom_contype[g] == 0 and m.geom_conaffinity[g] == 0:
            continue
        if m.geom_type[g] == mujoco.mjtGeom.mjGEOM_BOX:
            R = d.geom_xmat[g].reshape(3, 3); s = m.geom_size[g]
            for sx in (-1, 1):
                for sy in (-1, 1):
                    for sz in (-1, 1):
                        zmin = min(zmin, (d.geom_xpos[g] + R @ (s * [sx, sy, sz]))[2])
        else:
            zmin = min(zmin, d.geom_xpos[g][2] - m.geom_rbound[g])
    z0 = -zmin + 0.002
    qpos = np.zeros(m.nq); qpos[:7] = [0, 0, z0, 1, 0, 0, 0]
    rel = os.path.relpath(model_path, os.path.dirname(os.path.abspath(scene_path)))
    with open(scene_path, "w", encoding="utf-8") as f:
        f.write(f"""<!-- Copyright 2026 Masaaki Hijikata. SPDX-License-Identifier: Apache-2.0 -->
<!-- Viewer scene for {os.path.basename(model_path)}: floor + standing keyframe. -->
<mujoco model="{os.path.splitext(os.path.basename(model_path))[0]}_scene">
  <include file="{rel}"/>
  <visual>
    <headlight diffuse="0.6 0.6 0.6" ambient="0.3 0.3 0.3" specular="0 0 0"/>
    <global azimuth="160" elevation="-20"/>
  </visual>
  <asset>
    <texture type="skybox" builtin="gradient" rgb1="0.3 0.5 0.7" rgb2="0 0 0" width="512" height="3072"/>
    <texture type="2d" name="groundplane" builtin="checker" mark="edge" rgb1="0.2 0.3 0.4" rgb2="0.1 0.2 0.3" markrgb="0.8 0.8 0.8" width="300" height="300"/>
    <material name="groundplane" texture="groundplane" texuniform="true" texrepeat="5 5" reflectance="0.2"/>
  </asset>
  <worldbody>
    <light pos="0 0 3.5" dir="0 0 -1" directional="true"/>
    <geom name="floor" size="0 0 0.05" type="plane" material="groundplane"/>
  </worldbody>
  <keyframe>
    <key name="standing" qpos="{fmt(qpos)}"/>
  </keyframe>
</mujoco>
""")
    print("wrote", scene_path, f"(standing z0={z0:.4f})")

if __name__ == "__main__":
    main()
