hijimasa/reduced-dof-humanoid/tools/make_parts.py

#!/usr/bin/env python3
# Copyright 2026 Masaaki Hijikata
# SPDX-License-Identifier: Apache-2.0
"""Printable drafts of the parts the parallel-link conversion adds (CadQuery).

All numbers are in the LEG frame of Microban's Onshape parts (femur_right.step,
tibia_right.step, ankle_dbl_block.step share it): x lateral (+ = outboard on the right
leg), y forward, z up, millimetres. Pivot layout (docs/parts_ja.md):

    hip pitch axis   (y  3.0, z 132.7)    knee axis (8.0, 70.7)    ankle axis (0.0, 9.5)
    thigh linkage    hip pivot (-19.0, 124.7)  ->  knee pivot (-14.0,  62.7)   bar 62.2 mm (BEHIND)
    shank linkage    knee pivot (-17.0,  95.7)  ->  ankle pivot (-25.0, 34.5)  bar 61.7 mm (behind)

These are DRAFTS for fit-checking against the originals in Onshape, not release parts:
the screw holes that mate with Microban's brackets are placed from the STEP files'
hole patterns, but nothing here has been printed.

usage: <venv with cadquery>/bin/python tools/make_parts.py model/parts [path/to/microban/cad/step/foot.step]
"""
import math, os, sys
import cadquery as cq

OUT = sys.argv[1] if len(sys.argv) > 1 else "model/parts"
os.makedirs(OUT, exist_ok=True)

# ---- layout (mm, leg frame) --------------------------------------------------------
HIP, KNEE, ANKLE = (3.0, 132.7), (8.0, 70.7), (0.0, 9.5)
THIGH_BACK, THIGH_DOWN = 22.0, 8.0        # the thigh linkage runs BEHIND the thigh, pivots 8 mm down: the hip-side pivot then sits
                                          # beside the hip bracket's rear skirt on a short lug, and the femur never sweeps that spot
SHANK_BACK, SHANK_UP = 30.0, 30.0
P1H = (HIP[0] - THIGH_BACK, HIP[1] - THIGH_DOWN)      # thigh bar, hip end
P1K = (KNEE[0] - THIGH_BACK, KNEE[1] - THIGH_DOWN)    # thigh bar, knee end
P2K = (KNEE[0] - SHANK_BACK, KNEE[1] + SHANK_UP)      # shank bar, knee end
P2A = (ANKLE[0] - SHANK_BACK, ANKLE[1] + SHANK_UP)    # shank bar, ankle end
BAR_T, BAR_W, PIN_D = 3.0, 8.0, 2.2                    # bar thickness, width, M2 clearance
PLATE_X = 18.5          # outer face of the femur / tibia clevis plates
THIGH_BAR_X = (35.0, 38.0)   # OUTSIDE the knee yoke and its axle stub: a rear thigh bar sweeps close to the knee axis
                             # flexion beyond 100 deg the (front) thigh bar sweeps across the knee axis
SHANK_BAR_X = (26.0, 29.0)   # next to the yoke, no spacer   # one plane further out: at deep hip flexion the (front) thigh bar crosses
                             # back over the knee and would otherwise hit the shank bar's upper end
YOKE_ARM_X = (29.5, 32.5)    # knee yoke plate, outside both bars

def dist(p, q): return math.hypot(q[0] - p[0], q[1] - p[1])

def bar(length, name):
    """Flat link: two Ø2.2 holes `length` apart, rounded ends, 3 x 8 mm section."""
    b = (cq.Workplane("XY").slot2D(length + BAR_W, BAR_W).extrude(BAR_T)
         .faces(">Z").workplane().pushPoints([(-length / 2, 0), (length / 2, 0)]).hole(PIN_D))
    cq.exporters.export(b, f"{OUT}/{name}.stl"); return b

def knee_yoke(side="right"):
    """One flat plate OUTBOARD of the leg (x 20.5..23.5 on the right) that ties the knee axle to
    the two rear-link pivots: a Ø8.2 bore on the knee axis, the thigh pin at P1K and the
    shank pin at P2K, each pin reaching inboard to its bar. No block behind the knee and no
    inner bar: the first draft's crossbar ran straight through the bars' paths and the inner
    thigh bars of the two legs were only 8 mm apart, so both were dropped. The plate sits
    below the hanging forearm (which starts at z 112) and outside the femur/tibia plates."""
    sx = 1 if side == "right" else -1
    x0, x1 = (YOKE_ARM_X if sx > 0 else (-YOKE_ARM_X[1], -YOKE_ARM_X[0]))
    pts = [KNEE, P1K, P2K]
    # plate outline: the triangle of the three pivots offset by 5 mm, plus a Ø16 boss round the
    # knee bore. 5 mm (not 7) keeps the top of the plate 2 mm lower: in the walk the hanging
    # forearm passes 3 mm above it when the hip is flexed 45 deg
    tri = cq.Workplane("YZ").workplane(offset=x0).polyline(pts).close().offset2D(5.0).extrude(x1 - x0)
    tri = tri.union(cq.Workplane("YZ").workplane(offset=x0).center(*KNEE).circle(8.0).extrude(x1 - x0))
    plate = tri.cut(cq.Workplane("YZ").center(*KNEE).circle(4.1).extrude(60, both=True))
    # thigh pin: Ø2 (M2 screw) through the plate, with an integral Ø6 spacer down to the bar
    # plane (thigh bar at THIGH_BAR_X, shank bar at SHANK_BAR_X: the spacer fills the gap)
    for p, bar_x in ((P1K, THIGH_BAR_X), (P2K, SHANK_BAR_X)):
        if bar_x[0] >= YOKE_ARM_X[1]:            # bar OUTSIDE the plate: spacer grows outward from the plate's outer face
            gap = bar_x[0] - 0.5 - YOKE_ARM_X[1]
            sp = cq.Workplane("YZ").workplane(offset=x1 if sx > 0 else x0 - gap).center(*p).circle(3.0).extrude(gap)
        else:                                    # bar inside: spacer fills the gap down to the bar plane
            gap = (x0 - bar_x[1] if sx > 0 else bar_x[1] - abs(x1)) - 0.5
            sp = cq.Workplane("YZ").workplane(offset=(x0 - gap) if sx > 0 else -abs(x1)).center(*p).circle(3.0).extrude(gap) if gap > 0.1 else None
        if sp is not None and gap > 0.1:
            plate = plate.union(sp)
        plate = plate.cut(cq.Workplane("YZ").center(*p).circle(PIN_D / 2).extrude(60, both=True))
    cq.exporters.export(plate, f"{OUT}/knee_yoke_{side}.stl"); return plate


def hip_block_integrated(step_dir, out_dir, side):
    """Microban's hip bracket (hip_dbl_block_{side}.step: the cap under the hip roll and pitch servos,
    with a front tab for the roll-axis idler) with the thigh bar's upper pivot grown out of it.
    Frame = the leg frame (x lateral, +x outboard on the right; y forward; z up), mapped into the
    bracket's STEP frame with p_step = diag(-1, -1, 1) p_leg + t (t from robot.xml).

    With the thigh linkage BEHIND the thigh and its pivots 12 mm below the axes, the hip-side pivot
    P1H = (-29, 120.7) sits right beside the bracket's rear skirt (x 11.5..13.5, y -30..-6,
    z 117..125), in the quadrant behind and below the hip axis that the femur's clevis plates
    only brush at full extension and that the pelvis-side bracket (x +-9 there) does not reach.
    So the support is a short lug: a flange on the skirt and a tapered, filleted lug out to the
    bar plane with the pin hole; the root is not a right angle. The __main__ report checks it in CAD against the femur over the hip range
    and against the pelvis-side bracket over the roll range."""
    t = {"right": (0.0, -9.75, -105.71), "left": (27.0, -9.75, -105.71)}[side]
    sx = 1.0 if side == "right" else -1.0
    X = lambda x0, x1: (min(sx * x0, sx * x1), max(sx * x0, sx * x1))
    # Root: a flange on the skirt spreads the load into the thin wall; the lug tapers from a 20 x 22
    # section at the wall to 10 x 10 at the pin, and the junction is filleted (no right-angled
    # root). Built for the right leg (+x outboard) and mirrored for the left.
    x_tip = THIGH_BAR_X[0] - 0.5
    flange = _box(11.0, 14.0, P1H[0] - 11.0, P1H[0] + 11.0, P1H[1] - 12.0, P1H[1] + 12.0).edges("|X").fillet(3.0)
    # the taper narrows to 12 x 12 within 2 mm so that, beyond the femur plates' inner face (14.5),
    # nothing of the lug reaches the corner the plates sweep at full extension
    neck = (cq.Workplane("YZ").workplane(offset=13.0).center(P1H[0], P1H[1]).rect(20.0, 22.0)
            .workplane(offset=2.0).rect(12.0, 12.0).loft(combine=True))
    lug = (cq.Workplane("YZ").workplane(offset=15.0).center(P1H[0], P1H[1]).rect(12.0, 12.0)
           .workplane(offset=x_tip - 15.0).rect(10.0, 10.0).loft(combine=True))
    sup = flange.union(neck).union(lug)
    try:
        sup = sup.edges(cq.selectors.BoxSelector((13.5, P1H[0] - 12, P1H[1] - 13), (14.5, P1H[0] + 12, P1H[1] + 13))).fillet(2.5)
    except Exception:
        pass
    try:
        sup = sup.edges(cq.selectors.BoxSelector((x_tip - 1, P1H[0] - 6, P1H[1] - 6), (x_tip + 1, P1H[0] + 6, P1H[1] + 6))).fillet(1.5)
    except Exception:
        pass
    sup = sup.cut(_cyl(PIN_D / 2, (8, P1H[0], P1H[1]), (40, P1H[0], P1H[1])))
    if side == "left":
        sup = sup.mirror("YZ")
    sup = sup.rotate((0, 0, 0), (0, 0, 1), 180).translate(t)           # leg -> bracket STEP frame
    blk = cq.importers.importStep(os.path.join(step_dir, f"hip_dbl_block_{side}.step"))
    part = blk.union(sup)
    assert len(part.solids().vals()) == 1, f"hip_block_integrated_{side}: support not fused ({len(part.solids().vals())} solids)"
    os.makedirs(out_dir, exist_ok=True)
    cq.exporters.export(part, f"{out_dir}/hip_block_integrated_{side}.stl")
    cq.exporters.export(part, f"{out_dir}/hip_block_integrated_{side}.step")
    return part

def knee_axle_cap():
    """Bolts onto the knee servo horn through the femur plate with the four M2 horn screws
    (PCD 12, lengthened to M2x12) and carries an Ø8 stub axle for the yoke, from the
    plate's outer face (x 18.5) out to x 34; M2 tapped hole in the tip for a retainer."""
    cap = (cq.Workplane("XY").circle(9.0).extrude(2.0)                   # 2 mm flange on the plate
           .faces(">Z").workplane().circle(4.0).extrude(12.5))           # Ø8 stub through the yoke plate at 29.5..32.5, 0.5 proud; countersunk M2 retainer
    cap = cap.faces("<Z").workplane().pushPoints([(6, 0), (-6, 0), (0, 6), (0, -6)]).hole(2.2)
    cap = cap.faces(">Z").workplane().hole(1.6, 5.0)                    # M2 tap drill in the stub
    cq.exporters.export(cap, f"{OUT}/knee_axle_cap.stl"); return cap

def standoff(length, name):
    """Spacer between a bracket wall and a bar, M2 clearance through."""
    s = cq.Workplane("XY").circle(3.0).extrude(length).faces(">Z").workplane().hole(PIN_D)
    cq.exporters.export(s, f"{OUT}/{name}.stl"); return s

def xl330_dummy(name, horn=True, horn_rot=0.0):
    """Placeholder block with the XL330's envelope (20 x 34 x 26, horn axis at the origin,
    horn face at z = -19.5) for a servo position that is no longer driven: shoulder roll,
    neck. Back-face holes 4 x Ø2.2 on a 16 x 25.5 mm rectangle as read from the
    brackets' STEP files; verify against the real servo before printing.
    horn_rot turns the fixed horn's hole pattern about the axis [deg]: the shoulder-roll
    blocks use +-30 so the arm hangs abducted 30 deg (see make_microban_pl.py --arm-abduct)."""
    body = cq.Workplane("XY").box(20, 34, 26, centered=(True, False, False)).translate((0, -24.5, -19.5))
    body = body.cut(cq.Workplane("XY").box(16, 30, 22, centered=(True, False, False)).translate((0, -22.5, -17.5)))   # 2 mm shell, ~7 g
    body = body.faces("<Y").workplane().pushPoints([(-8, -8.0), (8, -8.0), (-8, 17.5), (8, 17.5)]).hole(2.2, 8)
    if horn:   # fixed horn disc: PCD 12 M2 holes and the Ø7.2 centre boss, as on the idle horn
        c, s_ = math.cos(math.radians(horn_rot)), math.sin(math.radians(horn_rot))
        pts = [(6 * c, 6 * s_), (-6 * c, -6 * s_), (-6 * s_, 6 * c), (6 * s_, -6 * c)]
        disc = cq.Workplane("XY").circle(8.0).extrude(-3.0).translate((0, 0, -19.5))
        disc = disc.faces("<Z").workplane().pushPoints(pts).hole(1.6)
        body = body.union(disc).union(cq.Workplane("XY").circle(3.6).extrude(-1.5).translate((0, 0, -22.5)))
    cq.exporters.export(body, f"{OUT}/{name}.stl"); return body

def ankle_hinge_dummy(name="xl330_dummy_ankle_hinge"):
    """Goes where the ankle-pitch servo was, inside the unchanged ankle_dbl_block: the XL330
    envelope with the bracket's back-face holes, and in place of horn and idler two Ø5.9
    stub axles that ride in the tibia plates' existing Ø6 holes (plates are 4.5 mm off the
    servo faces, 4 mm thick). Each stub is retained from outside by an M2 screw and washer
    (M2 tap drill in the stub). The shank bar's pivot is NOT on this part: it is an M2
    hole added to the ankle bracket's side wall at (y -25.0, z 34.5)."""
    body = cq.Workplane("XY").box(20, 34, 26, centered=(True, False, False)).translate((0, -24.5, -19.5))
    body = body.faces("<Y").workplane().pushPoints([(-8, -8.0), (8, -8.0), (-8, 17.5), (8, 17.5)]).hole(2.2, 8)
    # The clevis is not symmetric about the servo: on the horn side the plate's inner face is
    # 4.5 mm off the servo face (horn 3 mm + 1.5), on the idler side the plate sits directly
    # on the servo face (the idle cap lives in the plate's hole). Spacers follow suit.
    for z_face, direction, gap in ((-19.5, -1, 4.5), (6.5, 1, 0.5)):
        spacer = cq.Workplane("XY").circle(6.0).extrude(gap * direction).translate((0, 0, z_face))
        stub = cq.Workplane("XY").circle(2.95).extrude(5.5 * direction).translate((0, 0, z_face + gap * direction))  # through the 4 mm plate + 1.5
        body = body.union(spacer).union(stub)
    body = body.cut(cq.Workplane("XY").circle(0.8).extrude(60, both=True))   # M2 tap drill along the axis, both stubs
    cq.exporters.export(body, f"{OUT}/{name}.stl"); return body


def foot_sole80(step_path, out_dir, sole=80.0):
    """Microban's foot with the toe end of the sole plate cut back so the ground-contact
    plate is `sole` mm long (ROBO-ONE Light: <= 55 % of the leg length; 90 mm on this
    146 mm leg is too long). The ankle bracket sits over the rear of the plate, so only
    the toe is cut. A derivative of Microban's CAD: CC BY-NC-SA 4.0, see
    model/parts_derived/LICENSE."""
    f = cq.importers.importStep(step_path)
    bb = f.val().BoundingBox()                       # plate y -41.5 .. 48.5, y = forward
    keep_to = bb.ymin + sole
    short = f.cut(cq.Workplane("XY").box(200, 200, 200).translate((0, keep_to + 100, 0)))
    os.makedirs(out_dir, exist_ok=True)
    cq.exporters.export(short, f"{out_dir}/foot_sole{int(sole)}.stl")
    cq.exporters.export(short, f"{out_dir}/foot_sole{int(sole)}.step")
    return short


# ---------------------------------------------------------------------------------------------
# Integrated parts: the printed servo-shaped spacers merged with the part they bolt to.
# Geometry of the interfaces comes from Microban's robot.xml (servo poses) and STEP files.
# The ankle block and upper arm are derived from Microban's CAD (CC BY-NC-SA 4.0) and are
# written to parts_derived/; the neck post is an original part.
# ---------------------------------------------------------------------------------------------
def _cyl(r, p0, p1):
    """Solid cylinder of radius r from point p0 to point p1 (mm)."""
    v = cq.Vector(*p1) - cq.Vector(*p0)
    return cq.Workplane("XY").add(cq.Solid.makeCylinder(r, v.Length, cq.Vector(*p0), v.normalized()))

def _box(x0, x1, y0, y1, z0, z1):
    return cq.Workplane("XY").box(x1 - x0, y1 - y0, z1 - z0, centered=False).translate((x0, y0, z0))

def _pcd_points(r, n, rot_deg, axis):
    """n points on a circle of radius r in the plane normal to `axis` ('x','y' or 'z'), rotated rot_deg."""
    pts = []
    for k in range(n):
        a = math.radians(rot_deg + 360.0 * k / n)
        u, v = r * math.cos(a), r * math.sin(a)
        pts.append({"x": (0, u, v), "y": (v, 0, u), "z": (u, v, 0)}[axis])
    return pts

def ankle_block_integrated(step_dir, out_dir, side):
    """Microban's ankle_dbl_block (the cap that ties the two ankle servos together) merged
    with a printed hinge body in the place of the ankle-pitch servo.

    Frame = the block's own STEP frame (x lateral, y forward, z up); this is also the leg
    frame: pitch axis along x through (y 0, z 9.5), roll axis along y through (x 0, z 9.5).
    The pitch servo occupied x -11.5..14.5, y +-10, z 0..34 with its horn at x -11.5 (horn
    disc -11.5..-14.5) and its idle cap at x 14.5; the tibia plates sit at |x| 14.5..18.5 with
    Ø6 holes on the axis. The cap bolted to the servo's top; here the hinge body is fused to it.
    The same part orientation is used in both legs (the block is not mirrored upstream), so
    the horn side (-x) is inboard on the right leg and outboard on the left; only the shank-bar
    pivot lug changes side: outboard = +x on the right leg, -x on the left. The lug is checked in
    CAD against the tibia over the knee range (__main__ report)."""
    cap = cq.importers.importStep(os.path.join(step_dir, "ankle_dbl_block.step"))
    body = _box(-9.0, 11.5, -6.0, 6.0, 9.5, 34.0)             # column from the hinge boss up to the cap
    pocket = _box(-7.4, 9.9, -4.4, 4.4, 14.0, 31.0)           # hollow, 1.6 mm walls
    web = _box(-9.0, 11.5, -1.0, 1.0, 9.5, 34.0)              # centre web
    boss = _cyl(6.0, (-11.5, 0, 9.5), (14.0, 0, 9.5))         # Ø12 hinge boss between the plates
    collar_h = _cyl(6.0, (-11.5, 0, 9.5), (-14.2, 0, 9.5))    # horn-side spacer, 0.3 mm off the plate (14.5)
    stub_h = _cyl(2.95, (-11.5, 0, 9.5), (-20.0, 0, 9.5))     # through the 4 mm plate + 1.5 for an M2 washer
    collar_i = _cyl(6.0, (14.0, 0, 9.5), (14.2, 0, 9.5))
    stub_i = _cyl(2.95, (14.0, 0, 9.5), (20.0, 0, 9.5))
    part = cap.union(body.cut(pocket)).union(web).union(boss).union(collar_h).union(stub_h).union(collar_i).union(stub_i)
    sx = 1.0 if side == "right" else -1.0                     # outboard side for the shank-bar pivot
    # Shank-bar pivot support. The tibia's clevis plates (|x| 14.5..18.5) sweep, relative to this
    # block, the band r <= 45 mm around the ankle axis (y 0, z 9.5) between 113 and 150 deg (their
    # rear-top corner, knee extension); the pivot P2A = (-30, 39.5) is at r 42, 135 deg, so the
    # support may only cross the plate zone at r > 45: a root block on the cap's rear corner
    # (inboard of the plates), a beam leaving it at y -44..-38, z 36..44 (r >= 46 from the axis),
    # and an arm outside the plates (x >= 21) coming forward to the pin. Built for +x (right) and
    # mirrored for the left.
    root = _box(11.0, 14.0, -38.5, -30.0, 31.0, 44.0).edges("|X").fillet(1.0)
    beam = _box(11.0, SHANK_BAR_X[0] - 0.5, -44.0, -38.0, 36.0, 44.0).edges("|X").fillet(1.5)
    arm = _box(21.0, SHANK_BAR_X[0] - 0.5, -44.0, P2A[0] + 5.0, 33.0, 44.0).edges("|X").fillet(1.5)
    piv = root.union(beam).union(arm).cut(_cyl(PIN_D / 2, (10, P2A[0], P2A[1]), (30, P2A[0], P2A[1])))   # M2 clearance for the pin
    if sx < 0:
        piv = piv.mirror("YZ")
    part = part.union(piv)
    part = part.cut(_cyl(0.8, (-21, 0, 9.5), (-15, 0, 9.5))).cut(_cyl(0.8, (15, 0, 9.5), (21, 0, 9.5)))   # M2 tap drills in the stub tips
    assert len(part.solids().vals()) == 1 and part.val().Volume() > 12000, f"ankle_block_integrated_{side}: bad boolean result"
    os.makedirs(out_dir, exist_ok=True)
    cq.exporters.export(part, f"{out_dir}/ankle_block_integrated_{side}.stl")
    cq.exporters.export(part, f"{out_dir}/ankle_block_integrated_{side}.step")
    return part

def shoulder_arm_simple(side, abduct=30.0):
    """Shoulder bracket + upper arm as ONE stout printed part (original design; only Microban's
    interfaces are kept, from robot.xml and the STEP hole patterns). Frame = the humerus STEP
    frame (y = the robot's forward axis, the former roll axis).

    - shoulder-pitch horn: a 4 mm plate at x -52.2..-48.2 with the horn's PCD 12 M2 holes around
      (y 0, z 24.5) and a Ø7.5 centre hole. The screws are driven from the outboard side, so Ø5
      access holes continue through the body (stepped hole: head on the plate, driver through).
    - elbow servo: Microban's humerus-plate pattern, 25.4 x 16 (x -45.4 / -20.0, y +-8), through a
      5 mm plate whose underside has a 1.5 mm pocket (26.4 x 20.4) that locates the servo's end;
      the servo's end face stays at z -2.5 as upstream.
    The arm (elbow plate + 16 x 16 post) is turned by the abduction angle about the former roll
    axis (x -32.7, z 24.5; -abduct for the right arm); a 24 x 18 x 21 body joins the horn plate
    to the post. The left part is the right part mirrored about the roll-axis plane x = -32.7,
    which is how Microban's left arm relates to its right (pitch horn at x -13.2 instead of
    -52.2, elbow horn at the other end), and which turns the abduction into +abduct. Walls 3 mm, outer edges chamfered, no overhangs when printed on
    the elbow plate."""
    cx, zc = -32.7, 24.5
    # elbow servo mount, as on Microban's humerus plate: the XL330 has no holes in its end face; it is
    # held by the top corner holes of its HORN-side face (x -44.2) and idler-side face, screws along
    # the horn axis (x). The plate's holes are at x -45.4 and -20.0, (y +-8, z -4.5): two short tabs
    # hang from the top plate, 2.4 mm thick, outside each face, with Ø2.2 holes along x.
    top = _box(-47.5, -17.5, -11.5, 11.5, -2.5, 1.5).edges("|Z").chamfer(1.5)
    tab_h = _box(-46.6, -44.2, -11.5, 11.5, -8.0, -2.5)        # horn side: holes at x -45.4
    tab_i = _box(-20.6, -18.2, -11.5, 11.5, -8.0, -2.5)        # idler side: holes at x -20.0
    elbow = top.union(tab_h).union(tab_i)
    for y in (-8.0, 8.0):
        elbow = elbow.cut(_cyl(1.1, (-48.0, y, -4.5), (-43.0, y, -4.5))).cut(_cyl(1.1, (-22.0, y, -4.5), (-17.0, y, -4.5)))
    post = _box(cx - 8.0, cx + 8.0, -8.0, 8.0, 0.0, 32.0).cut(_box(cx - 5.0, cx + 5.0, -5.0, 5.0, 3.0, 29.0))
    arm = elbow.union(post).rotate((cx, 0, zc), (cx, 1, zc), -abduct)       # right arm; the left is mirrored below
    plate = _box(-52.2, -48.2, -11.0, 11.0, 12.0, 37.0).edges("|X").chamfer(1.5)
    body = _box(-48.2, -24.0, -9.0, 9.0, 14.0, 35.0).cut(_box(-45.0, -27.0, -5.0, 5.0, 18.0, 31.0))
    part = plate.union(body).union(arm)
    part = part.cut(_cyl(3.75, (-53, 0, zc), (-47, 0, zc)))                      # horn centre boss
    for (y, z) in ((6.0, zc), (-6.0, zc), (0.0, 18.5), (0.0, 30.5)):
        part = part.cut(_cyl(1.1, (-53.0, y, z), (-47.0, y, z)))                # M2 clearance in the plate
        part = part.cut(_cyl(2.5, (-48.2, y, z), (-16.0, y, z)))                # driver access through body and post
    for r in (1.5, 1.0, 0.6):                                                   # round the outer edges; OCC may refuse the larger radii
        try:
            part = part.edges("not %CIRCLE").fillet(r); break
        except Exception:
            continue
    if side == "left":
        # Microban's left arm is the right arm mirrored about the plane of the roll axis (x = cx in
        # the humerus frame: the shoulder-pitch horn is at x -52.2 on the right and -13.2 on the
        # left, the elbow servo's horn flips to the other end). So the left part is the right part
        # mirrored about that plane; the mirror also turns the -30 deg abduction into +30.
        part = part.mirror("YZ", basePointVector=(cx, 0, 0))
    assert len(part.solids().vals()) == 1, f"shoulder_arm_simple_{side}: bad boolean result"
    cq.exporters.export(part, f"{OUT}/shoulder_arm_simple_{side}.stl")
    cq.exporters.export(part, f"{OUT}/shoulder_arm_simple_{side}.step")
    return part

def radius_long(step_dir, out_dir, ext=40.0):
    """Microban's forearm (radius.step) lengthened by `ext` mm: a Ø10 rod with a rounded end grown
    out of the hand tip along the forearm's axis (the part runs along -z, tip at z -98.5). ROBO-ONE
    Light allows 26 cm from the shoulder axis and asks for the hands to stay 50 mm above the floor
    while walking; with ext 40 the arm is 183 mm and the hands hang 72 mm up with straight arms in
    the walking crouch (102 mm with the elbows bent as the gaits use them)."""
    rad = cq.importers.importStep(os.path.join(step_dir, "radius.step"))
    vs = [(v.X, v.Y, v.Z) for v in rad.vertices().vals()]
    tip = [v for v in vs if v[2] < -88.0]
    cx = sum(v[0] for v in tip) / len(tip); cy = sum(v[1] for v in tip) / len(tip); z0 = min(v[2] for v in vs)
    rod = _cyl(5.0, (cx, cy, z0 + 6.0), (cx, cy, z0 - ext + 5.0)).union(
        cq.Workplane("XY").add(cq.Solid.makeSphere(5.0, cq.Vector(cx, cy, z0 - ext + 5.0))))
    part = rad.union(rod)
    assert len(part.solids().vals()) == 1, "radius_long: extension not fused"
    os.makedirs(out_dir, exist_ok=True)
    cq.exporters.export(part, f"{out_dir}/radius_long.stl")
    cq.exporters.export(part, f"{out_dir}/radius_long.step")
    return part

def head_integrated(step_dir, out_dir):
    """Microban's head with the neck grown out of it as one printed part. The servo-horn joint on
    the head's underside (PCD 12 holes, recess) is filled by a Ø24 pad and a plain Ø18 stalk
    centred on the former servo axis runs down into the pocket base, so nothing of the old horn
    interface remains. Frame = the head STEP frame, which is the trunk-top frame; the neck servo
    sat at (36, 7.79, 167.9) with its axis +z: pocket floor z 148.4, trunk top surface z 155.9,
    head underside z 174.4. Fixed from inside the trunk by the four M2 screws of the horn's PCD 12."""
    head = cq.importers.importStep(os.path.join(step_dir, "head.step"))
    ax = (36.0, 7.79)
    base = _box(-9.8, 9.8, -24.3, 9.3, -19.5, -12.0).cut(_box(-8.2, 8.2, -22.7, 7.7, -17.5, -12.0)).translate((ax[0], ax[1], 167.9))
    stalk = _cyl(9.0, (ax[0], ax[1], 155.9 - 0.5), (ax[0], ax[1], 175.0)).cut(_cyl(6.0, (ax[0], ax[1], 158.0), (ax[0], ax[1], 172.5)))
    pad = _cyl(12.0, (ax[0], ax[1], 174.4), (ax[0], ax[1], 178.0))
    part = head.union(pad).union(stalk).union(base)
    for (dx, dy, dz) in _pcd_points(6.0, 4, 0.0, "z"):
        part = part.cut(_cyl(0.8, (ax[0] + dx, ax[1] + dy, 147.5), (ax[0] + dx, ax[1] + dy, 154.5)))   # M2 taps, screws from inside the trunk
    os.makedirs(out_dir, exist_ok=True)
    cq.exporters.export(part, f"{out_dir}/head_integrated.stl")
    cq.exporters.export(part, f"{out_dir}/head_integrated.step")
    return part


if __name__ == "__main__":
    L1, L2 = dist(P1H, P1K), dist(P2K, P2A)
    assert abs(L1 - dist(HIP, KNEE)) < 1e-6 and abs(L2 - dist(KNEE, ANKLE)) < 1e-6, "parallelogram: bar = front link"
    bar(L1, "thigh_bar")           # x2 (one per leg, outboard)
    bar(L2, "shank_bar")           # x2 (one per leg, outboard)
    knee_yoke("right"); knee_yoke("left")
    knee_axle_cap()                # x2
    standoff(SHANK_BAR_X[0] - 13.5, "standoff_shank_ankle")  # 9 mm: ankle bracket wall (13.5) -> shank bar
    # shoulder roll: the horn pattern is indexed +30 deg (right) / -30 deg (left) about the roll
    # axis, which is the block's +z in both arms, so the arm hangs 30 deg abducted. (The humerus
    # is turned -30 / +30 in the model; the horn stays with the shoulder bracket.)
    xl330_dummy("xl330_dummy_shoulder_roll_right", horn_rot=30.0)
    xl330_dummy("xl330_dummy_shoulder_roll_left", horn_rot=-30.0)
    xl330_dummy("xl330_dummy_neck")            # x1
    xl330_dummy("xl330_dummy_hip_yaw")         # x2, the 12-servo kit's standard; swap for real XL330s to get 14
    ankle_hinge_dummy()                        # x2
    vols = {"shoulder_arm_simple_right": shoulder_arm_simple("right").val().Volume(),
            "shoulder_arm_simple_left": shoulder_arm_simple("left").val().Volume(),
            "xl330_dummy (shell)": xl330_dummy("xl330_dummy_hip_yaw").val().Volume()}
    # optional: parts derived from Microban's CAD (second argument = path to microban/cad/step or to foot.step)
    if len(sys.argv) > 2 and os.path.exists(sys.argv[2]):
        step_dir = sys.argv[2] if os.path.isdir(sys.argv[2]) else os.path.dirname(sys.argv[2])
        derived = os.path.join(os.path.dirname(OUT.rstrip("/")) or ".", "parts_derived")
        foot_sole80(os.path.join(step_dir, "foot.step"), derived)
        for side in ("right", "left"):
            vols[f"ankle_block_integrated_{side}"] = ankle_block_integrated(step_dir, derived, side).val().Volume()
            vols[f"hip_block_integrated_{side}"] = hip_block_integrated(step_dir, derived, side).val().Volume()
        vols["head_integrated"] = head_integrated(step_dir, derived).val().Volume()
        vols["radius_long"] = radius_long(step_dir, derived).val().Volume()
        for n in ("ankle_dbl_block", "hip_dbl_block_right", "head", "radius"):
            vols[n + " (original)"] = cq.importers.importStep(os.path.join(step_dir, n + ".step")).val().Volume()
        print("wrote the 80 mm foot, the integrated ankle blocks and the head into parts_derived/")
    print("volumes [cm3]:", {k: round(v / 1000, 2) for k, v in vols.items()})
    print(f"thigh bar {L1:.1f} mm, shank bar {L2:.1f} mm, pivots: thigh {P1H}->{P1K}, shank {P2K}->{P2A}")
    print("wrote", sorted(os.listdir(OUT)))
