hijimasa/reduced-dof-humanoid/(commit log)

2026-10-16 Add parallel-link Microban model (passive ankle pitch, fixed head)
    MuJoCo model of Rhoban's Microban in which the ankle-pitch servos are
    replaced by ashigaru-style parallelogram linkages and the neck servo is
    removed (19 -> 16 actuators), as the first step toward a 12-servo
    ROBO-ONE Light humanoid.
    - tools/make_microban_pl.py: generates the model from upstream robot.xml
    (upstream or LegacyMotionEditor joint naming, position actuators,
    viewer scene with standing keyframe)
    - tools/verify_parallel_leg.py: loop closure, foot-parallel sweep and
    standing tests (all passing)
    - tools/render_preview.py and docs/images/preview.png
    - docs/design_ja.md: DOF reduction study against ROBO-ONE Light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
    [ankle_dbl_block__configuration_right.stl, arm_bearing_support__configuration_right.stl, battery.stl, bts2_m2_6x8.stl, chest__configuration_right.stl, dc15_a01_horn_idle2_dummy.stl, dc15_a01_idle_cap_dummy.stl, femur__configuration_left.stl]
2026-10-16 Slim ankle block, remove neck servo, widen knee range (v2)
    The first get-up searches showed what blocked a reliable rise: the ankle
    U-bracket hit the hip bracket at 117 deg of knee flexion and the knee
    stopped at +96 deg. The generator now edits the model to match the parts
    the physical redesign has to produce:
    - ankle block without the ankle-pitch XL330, bracket cut to a clevis
    (47 g -> 25 g per ankle, self-collision limit 117 -> 132 deg)
    - neck servo removed from the trunk with the fixed head (-23 g)
    - rear-pivot tilt 5 -> 10 mm; joint ranges now derived from the linkage
    geometry with an 8 deg margin (hip -109..55, knee -55..109)
    - verify sweep clips test poses to the joint range
    Mas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
    [make_microban_pl.py, verify_parallel_leg.py]
2026-10-16 Add the 12-servo model (no hip yaw, no shoulder roll)
    tools/make_microban_pl.py --dof 12 removes the hip-yaw joints with their two
    XL330s in the trunk and the shoulder-roll joints with the XL330 at the top of
    each humerus. 0.765 -> 0.673 kg, 12 position actuators, verification passes.
    Models in model/microban_pl12/ share the meshes of model/microban_pl/.
2026-10-16 Document the 12-servo model
2026-10-16 Record the 12-servo motion verification results
2026-10-17 Add the 14-servo model and make it the chosen layout
    Shoulder roll removed, hip yaw kept so turning does not depend on the floor.
    --dof 14 in the generator; --dof 12 stays as a study. 0.719 kg.
2026-10-17 Part drafts, layout memo and per-linkage pivots
    - make_microban_pl.py: thigh and shank linkages get their own rear-pivot
    geometry (shank 25 mm back / 25 mm up clears the ankle-roll servo and the
    foot), link bars drawn as paired 3x8 mm bars, knee yoke drawn behind the knee
    - tools/make_parts.py (CadQuery): STL drafts of thigh/shank bars, knee yoke,
    knee axle cap, standoffs and dummy XL330 blocks; model/parts/*.stl
    - docs/parts_ja.md: pivot layout in the Onshape leg frame, packaging
    constraints found (arm 1 mm outboard, 6 mm between legs, servos behind the
    hip and ankle), part list, open fit checks; docs/images/parts_check.png
    - tools/step_holes.py: how the hole patterns were read fr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
    [knee_axle_cap.stl, knee_yoke_left.stl, knee_yoke_right.stl, shank_bar.stl, standoff_shank_ankle.stl, standoff_thigh_hip.stl, thigh_bar.stl, xl330_dummy_neck.stl]
2026-10-17 12-servo standard with printed spacers, 14-servo upgrade; cost estimate
    Every removed servo is now a printed XL330-shaped block in the model (visual
    and 8 g), so the original brackets stay unchanged and servos can be added back.
    Parts: hip-yaw spacer and the ankle passive-hinge block (stub axles into the
    tibia's existing holes). README/design doc: cost table from Microban's BOM.
    [xl330_dummy_ankle_hinge.stl, xl330_dummy_hip_yaw.stl]
2026-10-17 Record final verification: 12- and 14-servo builds pass every action 8/8
2026-10-17 Draw the printed parts as meshes; place them from the leg's centre plane
    - make_microban_pl.py --parts: link bars, knee yoke, axle cap and the dummy
    servo blocks (hip yaw, shoulder roll, neck, ankle hinge) are STL meshes from
    tools/make_parts.py instead of boxes, so LegacyMotionEditor's preview shows them
    - lateral placement measured from the knee servo's centre: the femur/tibia body
    origins sit on the inboard clevis plate, 14.5 mm off centre, which had put the
    bars and the left yoke in the wrong place
    - ankle hinge dummy: asymmetric spacers (4.5 mm horn side, 0.5 mm idler side)
    [xl330_dummy_ankle_hinge.stl]
2026-10-17 Rename the passive joints out of LME's Meridim slot table
    LegacyMotionEditor published the passive knee-block angle under the name
    r_knee_yp_1, which its JOINT_TO_MERIDIM table aliases to the knee servo's
    own slot, so MuJoCo Studio's knee target flipped between two values at
    100 Hz and the robot shook itself off its feet. The passive joints are now
    r_kneeblock_yp / r_thighlink_yp / r_shanklink_yp / r_anklepassive_yp.
    [make_microban_pl.py]
2026-10-17 Japanese README, green parts in the renders, elbow back to Microban's range
    - README_ja.md (full Japanese version), linked from README.md
    - added mechanism parts drawn green and the printed servo-shaped spacers amber;
    previews and the placement check re-rendered
    - elbow range back to the upstream +-125 deg by default (--elbow-flexion-only
    as an option): forward-only flexion cost the prone get-up most of its
    robustness (15/16 -> <= 5/16) and the forearm clears the upper arm either way
    - model masses corrected in the docs (16-servo 0.795 kg with its spacers)
    [make_microban_pl.py]
2026-10-17 README: 12-servo standard first, both builds in the tables, stale sections removed
    Drops the outdated Japanese summary (README_ja.md replaces it), fixes the parts
    table, usage and roadmap, and adds the elbow, Studio and naming lessons to the
    design memo.
2026-10-17 ROBO-ONE Light rule check: 80 mm sole, taller walking stance
    - the model's ground-contact plate is now 80 mm by default (--sole-length),
    cut at the toe only because the ankle bracket covers the heel; Microban's
    90 mm sole exceeds 55 % of the 146 mm leg length
    - model/parts_derived/foot_sole80.{stl,step}: Microban's foot with 10 mm cut
    off the toe (CC BY-NC-SA 4.0 derivative), made by tools/make_parts.py when
    given the path to foot.step
    - README/README_ja/design memo: rule-check table (sole length and width,
    no overlap, no squat walking) and the re-tuned stance
    [foot_sole80.step, foot_sole80.stl]
2026-10-17 Fix link interference: front thigh bar, stacked planes, collision on the parts
    The link parts did interfere once given collision geometry: the inner thigh
    bars of the two legs were 8 mm apart, the thigh and shank bars crossed in one
    plane beyond 60 deg of hip flexion, and the hanging forearm hit the rear thigh
    bar and, in the walking crouch, the top of the knee yoke.
    - Thigh linkage moved in front of the thigh (pivots 22 mm ahead / 10 mm above
    the hip and knee axes) with a hip_front_ear on the hip bracket; one bar per
    side. Thigh bar, shank bar and knee yoke plate stacked outboard in separate
    planes (21-24 / 24.5-27.5 / 28-31 mm from the leg centre); yoke is a
    triangular plate with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
    [hip_front_ear.stl, knee_axle_cap.stl, knee_yoke_left.stl, knee_yoke_right.stl, standoff_shank_ankle.stl, standoff_thigh_hip.stl]
2026-10-17 Abduct the arms 30 deg with the shoulder-roll blocks; walk with elbows forward
    A hanging forearm sits right over the knee's link stack (22-32 mm from the leg
    centre vs the stack's 21-31 mm), so bending the elbows forward for a human-like
    walk hit the thigh bar and the knee yoke (0.6-3.5 mm). The fix, suggested by
    the user: the printed block that replaces the shoulder-roll servo holds the arm
    abducted 30 deg.
    - make_microban_pl.py --arm-abduct (default 30, 12/14-servo models): the
    humerus frame is turned about the removed roll axis, right -30 / left +30.
    --hip-flex-limit exposes the flexion cap (default 85).
    - make_parts.py: xl330_dummy_shoulder_roll_right/left with the horn's PCD 12
    p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
    [xl330_dummy_shoulder_roll.stl, xl330_dummy_shoulder_roll_left.stl, xl330_dummy_shoulder_roll_right.stl]
2026-10-17 Integrate the ankle, shoulder-roll and neck spacers into their base parts
    The XL330-shaped spacer blocks at the ankle hinge, the shoulder roll and the
    neck were stand-ins so Microban's parts could be reused unchanged. They are
    now merged with the parts they bolted to, generated by tools/make_parts.py
    from Microban's STEP files (second argument = microban/cad/step):
    - parts_derived/ankle_block_integrated_{right,left}: Microban's ankle cap plus
    a hinge body in the pitch servo's place (Ø12 boss, Ø5.9 stub axles into the
    tibia plates' holes, M2 retainers) and the shank-bar pivot boss on the
    outboard side. The cap is not mirrored upstream, so the boss side differs
    per leg while the hor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
    [ankle_block_integrated_left.step, ankle_block_integrated_left.stl, ankle_block_integrated_right.step, ankle_block_integrated_right.stl, foot_sole80.step, foot_sole80.stl, neck_post.stl, upper_arm_integrated_left.step]
2026-10-17 Grow the thigh-bar pivot out of the hip bracket; stout one-piece shoulder+arm; head with its neck
    Design round driven by the user's review of the previous integration:
    - The separate hip ear collided with the femur's clevis plates, which sweep a
    wide fan in front of the hip axis. The pivot support is now part of the hip
    bracket (parts_derived/hip_block_integrated_{right,left}): it leaves the
    bracket behind and below the axis, crosses under the plates where the femur
    never is, runs forward as an 18 mm tall rail outside the plates, rises beside
    the axis (clear of the pelvis bracket's top plate under roll) and carries the
    pivot in front. 3 mm plates, R2 corners. Checked in CAD agai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
    [ankle_block_integrated_left.step, ankle_block_integrated_left.stl, ankle_block_integrated_right.step, ankle_block_integrated_right.stl, foot_sole80.step, head_integrated.step, head_integrated.stl, hip_block_integrated_left.step]
2026-10-17 Thigh link behind the thigh with a short lug on the hip bracket; stout shoulder; corrected elbow mount
    Following the user's review:
    - Thigh linkage moved BEHIND the thigh (pivots 22 mm behind, 8 mm below the
    axes). With the arms abducted the old reason for a front bar is gone, and the
    hip-side pivot now sits beside the hip bracket's rear skirt, in the quadrant
    the femur's clevis plates never sweep: the support is a 10 x 10 x 23 mm lug
    grown out of the bracket (parts_derived/hip_block_integrated), replacing
    the long detour. Ranges widen to hip -100..+62, knee -37..+127.
    - With both bars behind the leg the thigh bar goes OUTSIDE the knee yoke
    (35-38 mm): inside it the yoke's shank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
    [ankle_block_integrated_left.step, ankle_block_integrated_left.stl, ankle_block_integrated_right.step, ankle_block_integrated_right.stl, foot_sole80.step, head_integrated.step, hip_block_integrated_left.step, hip_block_integrated_left.stl]
2026-10-17 Hip lug: flanged, tapered and filleted root
    The lug's root met the bracket's thin skirt at a right angle. It now has a
    22 x 24 mm flange on the wall, tapers from 20 x 22 to 12 x 12 within 2 mm
    (so nothing of it reaches the corner the femur plates sweep at full
    extension) and on to 10 x 10 at the pin, with a filleted junction. CAD checks
    against the femur (hip pitch range) and the pelvis-side bracket (roll range)
    stay at zero; check_clearance clean. Masses 12: 0.715 kg, 14: 0.745 kg.
    [ankle_block_integrated_left.step, ankle_block_integrated_right.step, foot_sole80.step, head_integrated.step, hip_block_integrated_left.step, hip_block_integrated_left.stl, hip_block_integrated_right.step, hip_block_integrated_right.stl]
2026-10-17 Ankle block: shank-bar pivot on a routed beam instead of a thin cantilevered boss
    The shank bar's lower pivot was a Ø6 boss cantilevered 13 mm from the ankle
    cap. The tibia's clevis plates sweep, relative to the ankle block, the band
    r <= 45 mm around the ankle axis between 113 and 150 deg (knee extension), and
    the pivot sits inside it at r 42, so the support may only cross the plate zone
    farther out: a root block on the cap's rear corner (inboard of the plates), an
    8 x 8 mm beam at y -44..-38 / z 36..44 (r >= 46) and an arm outside the plates
    back to the pin. Checked in CAD against the tibia over the knee range and the
    foot over the roll range (zero intersection); check_clearance clean.
    Ma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
    [ankle_block_integrated_left.step, ankle_block_integrated_left.stl, ankle_block_integrated_right.step, ankle_block_integrated_right.stl, foot_sole80.step, head_integrated.step, hip_block_integrated_left.step, hip_block_integrated_right.step]
2026-10-17 Left shoulder part is the mirror of the right about the roll-axis plane
    Microban's left arm is the right arm mirrored about the plane of the
    shoulder-roll axis (pitch horn at x -13.2 instead of -52.2 in the humerus
    frame, elbow horn at the other end). The left part was built as the right one
    with the opposite abduction sign, which put its horn plate on the wrong side.
    Now it is the right part mirrored about x = -32.7; verified numerically against
    both elbow servos and shoulder-pitch joints.
    [ankle_block_integrated_left.step, ankle_block_integrated_right.step, foot_sole80.step, head_integrated.step, hip_block_integrated_left.step, hip_block_integrated_right.step, shoulder_arm_simple_left.step, shoulder_arm_simple_left.stl]
2026-10-17 Forearms lengthened by 40 mm (parts_derived/radius_long)
    The arm was 143 mm from the shoulder axis, short next to KXR / Robovie-nano.
    ROBO-ONE Light allows 26 cm from the shoulder and wants the hands 50 mm above
    the floor while walking, so --forearm-ext now defaults to 0.04: Microban's
    forearm with a Ø10 rod grown out of the hand tip (arm 183 mm; hands 86 mm up
    with straight arms in the walking crouch, 114 mm with the elbows bent as the
    gaits use them). The collision capsule for the left forearm sits at
    z -0.0135, the mirror of the right's. Gaits and jabs stay 8/8 on both builds.
    Masses 12: 0.738 kg, 14: 0.768 kg.
    [ankle_block_integrated_left.step, ankle_block_integrated_right.step, foot_sole80.step, head_integrated.step, hip_block_integrated_left.step, hip_block_integrated_right.step, radius_long.step, radius_long.stl]
2026-10-17 Pre-publication review: docs brought in line with the final design
    - README / README_ja: status paragraph (parts integrated, only the hip-yaw
    spacer remains; nothing printed yet), part table rows (ankle support, hip
    bracket lug, rear link bars, forearm +4 g), part volumes and masses
    (12: 0.726 kg, 14: 0.756 kg, 16: 0.809 kg), walk speed 32 mm/s, honest
    get-up status with a pointer to where the motion tools live
    (LegacyMotionEditor), generator option list, roadmap, licence notes for
    parts_derived (CC BY-NC-SA) and parts (Apache-2.0).
    - NOTICE.md: provenance table covers every derived part; joint-range and
    --dof notes updated; --parts / --dummies behaviour described.
    - Forearm ex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
2026-10-17 Draw the shortened foot in green
    With --parts the foot mesh is swapped for parts_derived/foot_sole80 (the toe
    cut to an 80 mm contact length), so the changed part shows green like every
    other new or modified part; the mesh matches the cut collision plates
    (x -26..54 mm in the foot frame). Docs and preview images updated.
    [make_microban_pl.py]
2026-10-17 Add the motion tools and profiles (motion/) so the verification is reproducible here
    LegacyMotionEditor's tools/ is maintained elsewhere, so the scripts the
    verification tables depend on are copied into motion/ with their paths
    adjusted to this repository: robot profiles (microban, microban_pl,
    microban_12, microban_14 and the candidate profiles), leg IK and name
    mapping, build_project (keyframes -> LME project), sim_check (perturbed
    replay), the gait and get-up tuners and the get-up searches. The generated
    LME projects for both builds are in motion/projects/. Smoke-tested from the
    repository root (build + sim_check). motion/README.md documents the commands.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
2026-10-17 Get-ups found on the final geometry
    Prone rise searched with motion/getup_supine.py (eight seeds, robust 3):
    with the 40 mm longer forearms the search no longer ends in the kneeling
    local optimum, and seed 72's nine-pose roll-over rise, re-timed with
    motion/tune_getup.py, holds. Full sequential sim check (8 perturbed trials):
    12-servo: every gait and jab 8/8, prone 8/8, supine (roll + rise) 7/8
    14-servo: every gait and jab 8/8, prone 7/8, supine 8/8 (same poses and
    timing as the 12-servo build)
    A direct supine rise (sit up on the hands, hip to -100 deg) and a one-pose
    prone-to-supine roll were also found and are kept in motion/log as
    alternatives (microban_12_cand_sup profile evaluat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
2026-10-17 14-servo rise re-timed on its own model: prone 8/8, supine 7/8, 5.2 s
2026-10-17 Switch the supine get-up to a direct rise
    The eight-pose direct supine rise found on the final geometry (seed 80: sit up on
    the hands, fold the hip to -100 deg, squat, stand) replaces the one-pose roll onto
    the front followed by the prone rise. Re-timed with tune_getup.py face_up on each
    model: 12-servo 5.1 s, 8/8 (40/40 over 40 trials); 14-servo 4.8 s, 8/8 (39/40).
    The roll scheme held 7/8 (37/40) and took 8 s. Its roll poses are kept in
    motion/candidates/roll_to_prone_{12,14}.pkl; ROLL_TO_PRONE = [] in the profiles
    disables it. Full perturbed check: all 13 actions 8/8 on both builds.
2026-10-17 Count the shoulder part at its CAD volume (13.5 cm3)
    SHOULDER_ARM_CM3 in the generator was still the slim shoulder's 9.5 cm3 while
    make_parts.py reports 13.5 for the stout part, so each arm was 4 g light. Model
    masses are now 0.734 kg (12-servo) and 0.764 kg (14-servo); the docs follow,
    and docs/parts_ja.md's mass paragraph is brought up to the current parts. Both
    LME projects rebuilt; all 13 actions still 8/8 on both builds.
